rt-net/sciurus17_Hardware/README.md

# Sciurus17_Hardware

[Sciurus17](https://rt-net.jp/products/sciurus17/)のハードウェア資料集です



## フォルダ構成

- `3d_cad_data` : Sciurus17のCADデータ(step)が入っています。
- `3d_print_parts` : Afinia H800+を使った3Dプリント用印刷データと印刷設定リストが入っています。
- `Drawing` : アルミフレームのPDF図面とDXF図面が入っています。

## その他リンク集

- Sciurus17 Getting Start Guide (入門ガイド)
    - [製品ページ](https://rt-net.jp/products/sciurus17/)を参照してください
- [Sciurus17 リンク情報リファレンス](https://docs.google.com/spreadsheets/d/1Q4z3M3cS1pQOEn3iXKLiIQIOr6czvECxSXEPS2-PGvA/edit#gid=870791940)
- [Afinia印刷設定リスト](https://docs.google.com/spreadsheets/d/13tAhwWhuUY1OYwRSI2I5aivEmJeS_VqNS-mdT532pNQ/edit?usp=sharing)
- [組立マニュアル](https://sites.google.com/view/sciurus17-assembly-manual/)
- [部品表](https://docs.google.com/spreadsheets/d/1hBzEDzpoBd0SM8JSYE11qiUdSFQ6FFE922mXjGlsemY/edit?usp=sharing)
- [組立工具リスト](https://docs.google.com/spreadsheets/d/1ffTFrHghpTMQXYzQib9MbFNCAKSNk71CsP23wXIxDos/edit#gid=0)

## 知的財産権について

Sciurus17は、アールティが開発した研究用上半身ロボットです。このリポジトリの情報のライセンスについては、LICENSEファイルをご参照ください。企業による使用については、自社内において研究開発をする目的に限り、本ハードウェア情報の使用を許諾します。本ハードウェア情報を使って自作されたい方は、義務ではありませんが弊社ロボットショップで部品をお買い求めいただければ、励みになります。商業目的をもって本ハードウェア情報を使用する場合は、商業用使用許諾の条件について弊社までお問合せください。

サーボモータのXM540やXM430に関するCADモデルの使用については、ROBOTIS社より使用許諾を受けています。 Sciurus 17に使用されているROBOTIS社の部品類にかかる著作権、商標権、その他の知的財産権は、ROBOTIS社に帰属します。

Proprietary Rights

Sciurus17 is an upper body robot developed by RT Corporation for research purposes. Please read the license information contained in this repository to find out more about licensing. Companies are permitted to use Sciurus17 and the materials made available here for internal, research and development purposes only. If you are interested in building your own robot for your personal use by utilizing the information made available here, take your time to visit our website and purchase relevant components and parts – that will certainly help us keep going! Otherwise, if you are interested in using the hardware information herein on a commercial basis, please contact us to arrange a license and collaboration agreement with us.

We have obtained permission from ROBOTIS Co., Ltd. to use CAD models relating to servo motors XM540 and XM430. The proprietary rights relating to any components or parts manufactured by ROBOTIS and used in this product, including but not limited to copyrights, trademarks, and other intellectual property rights, shall remain vested in ROBOTIS.
