rt-net/sciurus17_Hardware/3d_print_parts/Sciurus17_Left_HandD2.stl

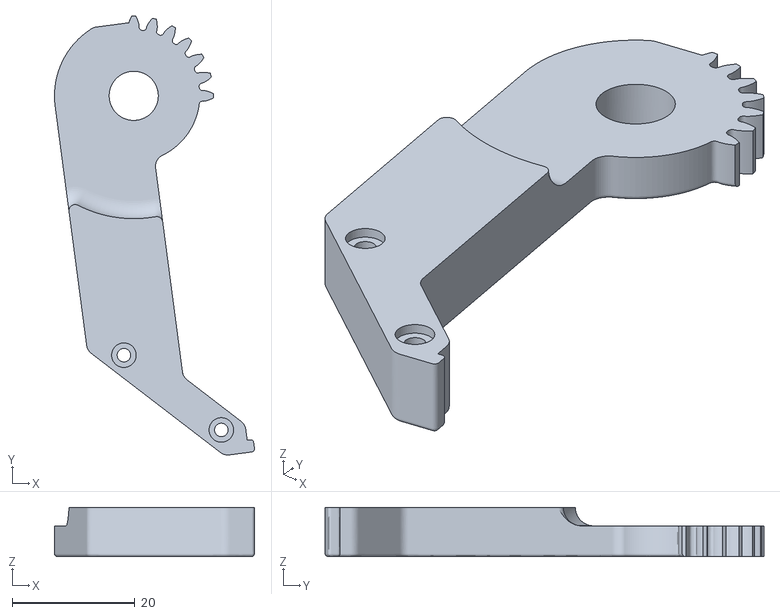
[picture p1: CAD file, 2020-09-11]
3d_print_parts/Sciurus17_Left_HandD2.stl
32.6 x 71.5 x 8.00
