rt-net/sciurus17_Hardware/Drawing/アルミフレームF.dxf

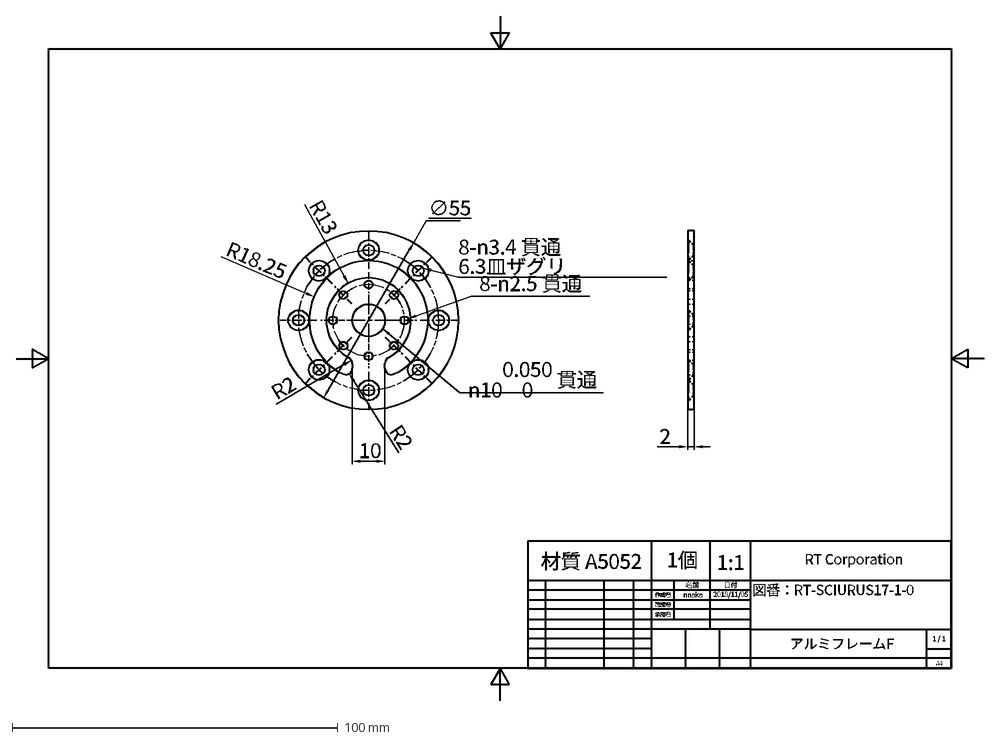
[picture p2: CAD file, 2018-11-06]
Drawing/アルミフレームF.dxf
アルミフレームF
図番：RT-SCIURUS17-1-0
RT Corporation
2018/11/05
nnaka
A4
名前
日付
作成者
確認者
承認者
1 / 1
2
∅55
R13
R18.25
R2
10
1個
材質 A5052
1:1
