rt-net/sciurus17_Hardware/3d_print_parts/Sciurus17_Left_HandD1.stl

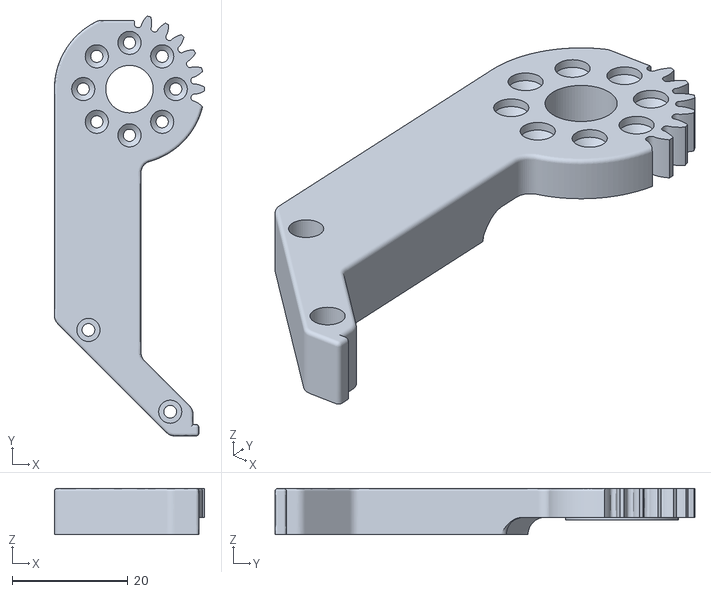
[picture p3: CAD file, 2020-09-11]
3d_print_parts/Sciurus17_Left_HandD1.stl
26.0 x 72.6 x 8.00
