rt-net/sciurus17_Hardware/Drawing/アルミフレームE.dxf

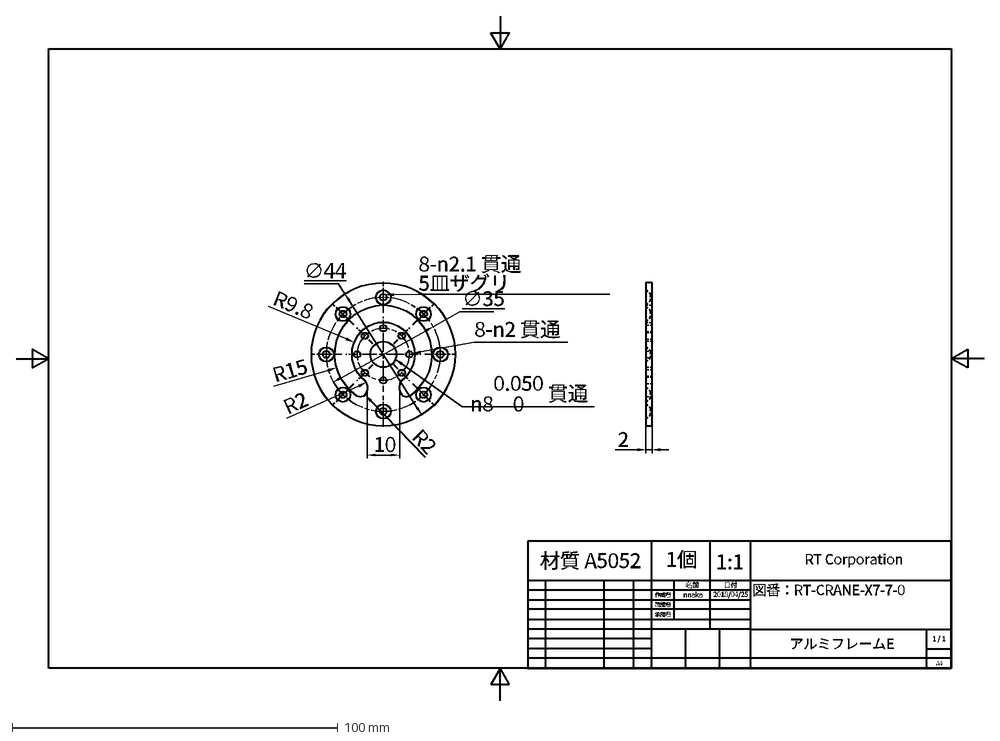
[picture p4: CAD file, 2018-11-06]
Drawing/アルミフレームE.dxf
アルミフレームE
図番：RT-CRANE-X7-7-0
RT Corporation
2018/04/25
nnaka
A4
名前
日付
作成者
確認者
承認者
1 / 1
∅44
∅35
R9.8
R15
10
R2
2
1個
材質 A5052
1:1
