rt-net/sciurus17_Hardware/3d_print_parts/Sciurus17_Right_HandA.stl

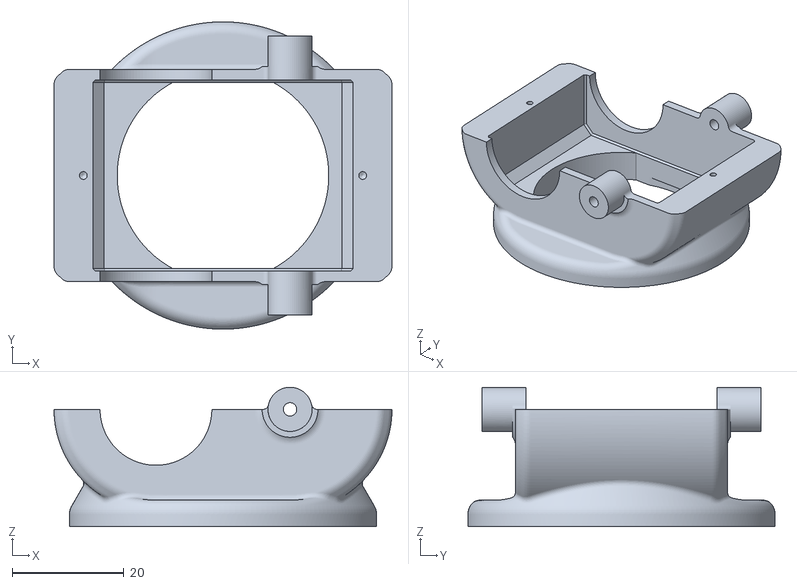
[picture p5: CAD file, 2020-09-11]
3d_print_parts/Sciurus17_Right_HandA.stl
60.5 x 55.0 x 25.0
