rt-net/sciurus17_Hardware/Drawing/アルミフレームD.dxf

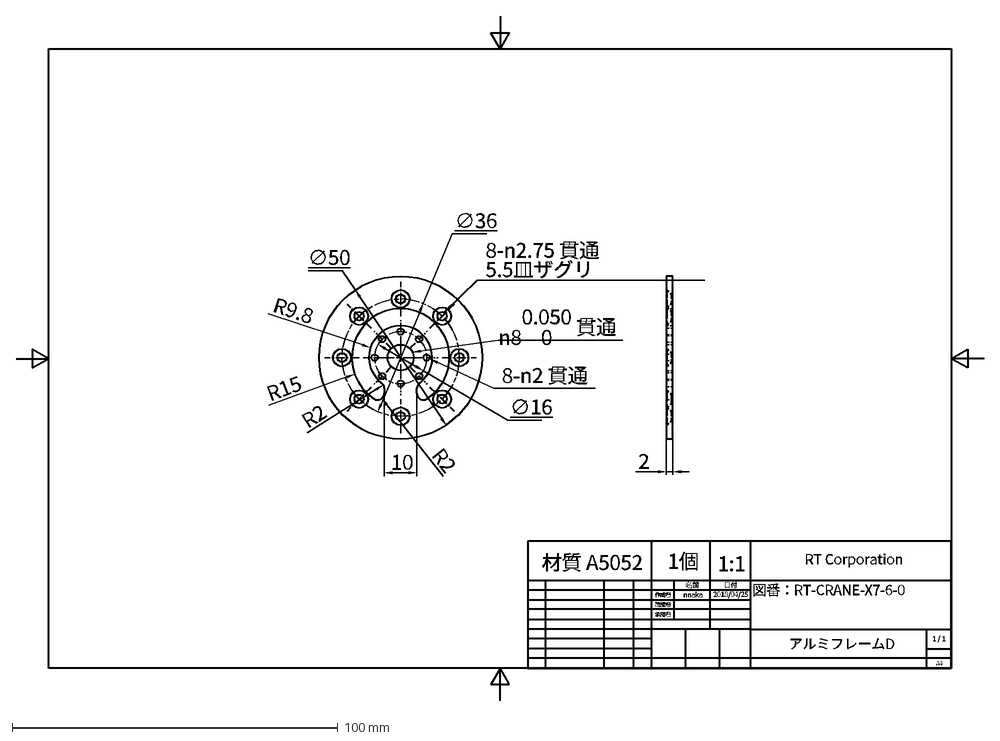
[picture p6: CAD file, 2018-11-06]
Drawing/アルミフレームD.dxf
アルミフレームD
図番：RT-CRANE-X7-6-0
RT Corporation
2018/04/25
nnaka
A4
名前
日付
作成者
確認者
承認者
1 / 1
∅50
∅36
2
10
R2
R9.8
R15
∅16
1:1
材質 A5052
1個
