rt-net/sciurus17_Hardware/3d_print_parts/Sciurus17_Left_HandD4.stl

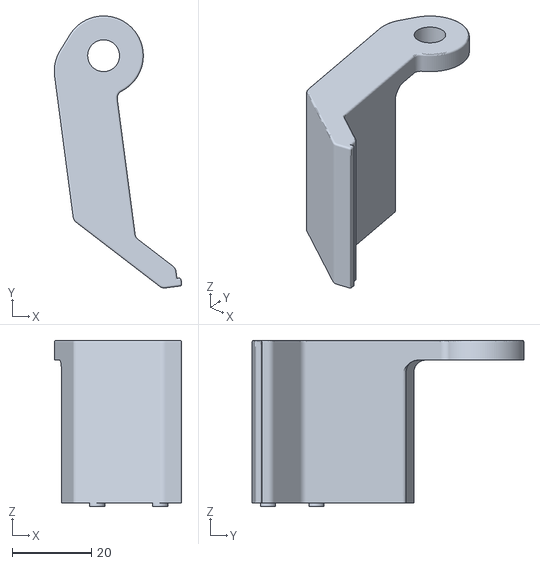
[picture p7: CAD file, 2020-09-11]
3d_print_parts/Sciurus17_Left_HandD4.stl
32.1 x 68.5 x 41.9
