rt-net/sciurus17_Hardware/Drawing/CRANE-X7_HandFrame20180417.dxf

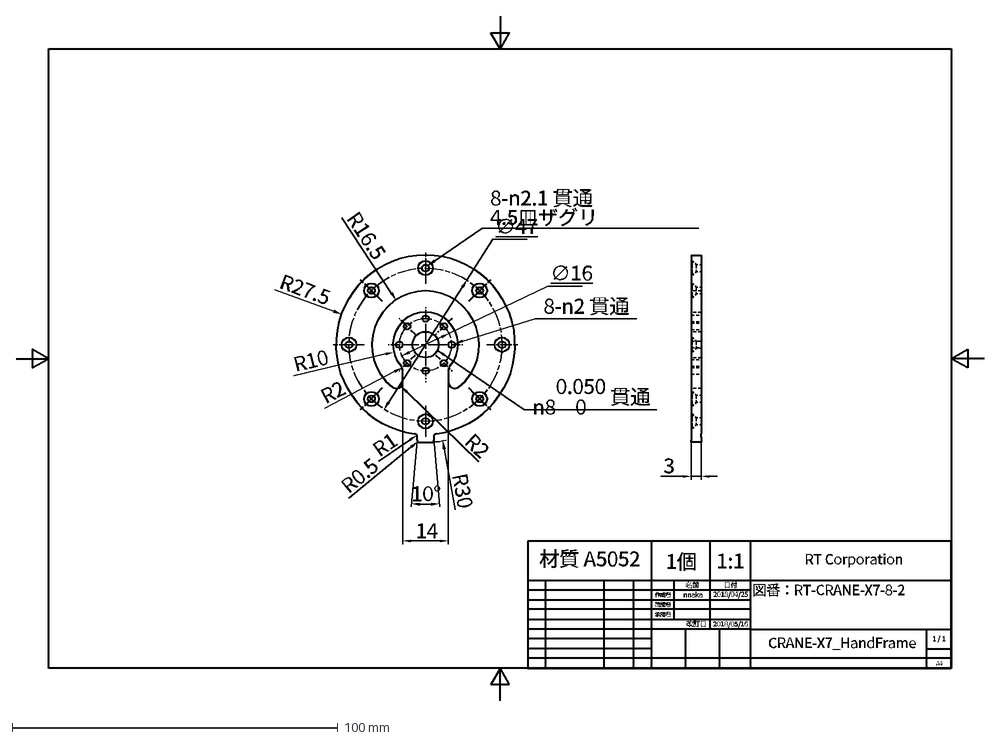
[picture p8: CAD file, 2018-11-06]
Drawing/CRANE-X7_HandFrame20180417.dxf
CRANE-X7_HandFrame
図番：RT-CRANE-X7-8-2
RT Corporation
2018/04/25
nnaka
A4
名前
日付
作成者
確認者
承認者
1 / 1
材質 A5052
1個
1:1
3
R27.5
R16.5
∅47
∅16
10°
R1
R0.5
R30
14
R2
R10
改訂日
2018/05/16
