rt-net/sciurus17_Hardware/3d_print_parts/Sciurus17_Right_HandB.stl

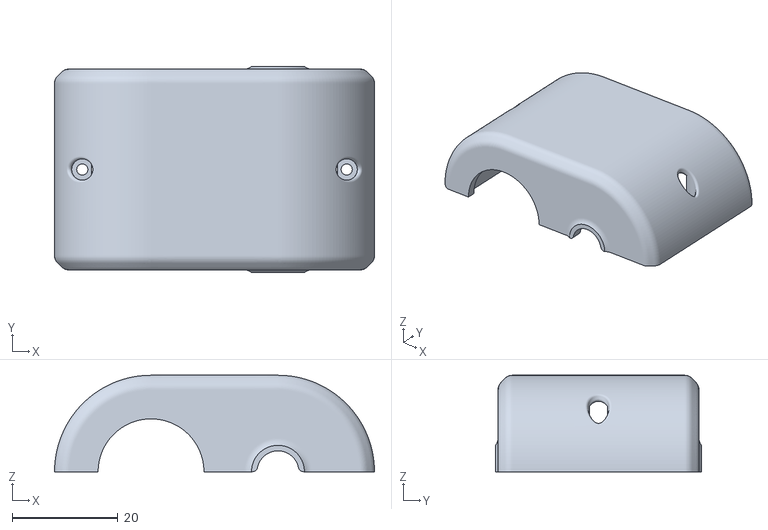
[picture p9: CAD file, 2020-09-11]
3d_print_parts/Sciurus17_Right_HandB.stl
60.5 x 39.0 x 18.3
