rt-net/sciurus17_Hardware/Drawing/アルミフレーム土台A.dxf

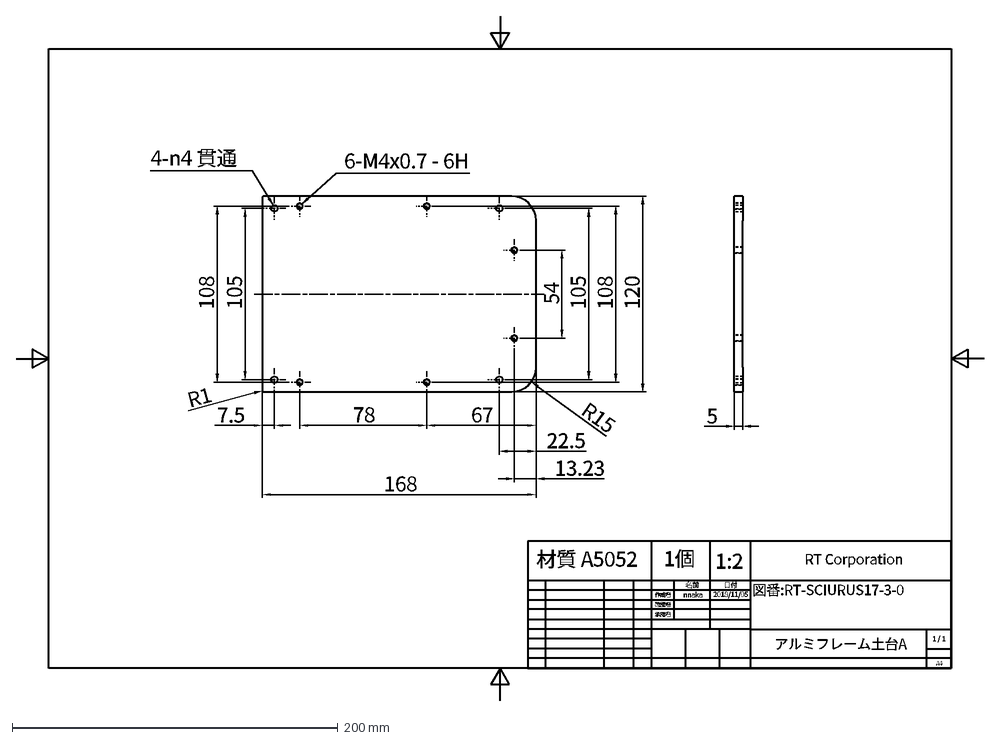
[picture p10: CAD file, 2018-11-06]
Drawing/アルミフレーム土台A.dxf
アルミフレーム土台A
図番:RT-SCIURUS17-3-0
RT Corporation
2018/11/05
nnaka
A4
名前
日付
作成者
確認者
承認者
1 / 1
78
22.5
7.5
67
13.23
54
105
108
120
6-M4x0.7 - 6H
R1
R15
168
5
1個
材質 A5052
1:2
