rt-net/sciurus17_Hardware/3d_print_parts/Sciurus17_Left_HandD3.stl

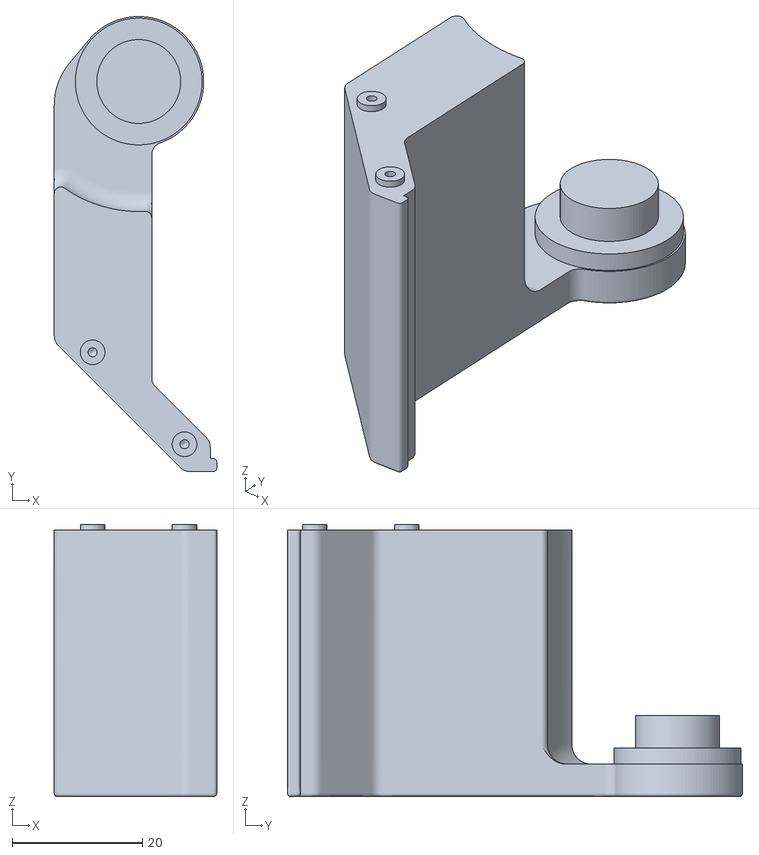
[picture p11: CAD file, 2020-09-11]
3d_print_parts/Sciurus17_Left_HandD3.stl
25.0 x 70.0 x 41.9
