rt-net/sciurus17_Hardware/Drawing/アルミフレームA.dxf

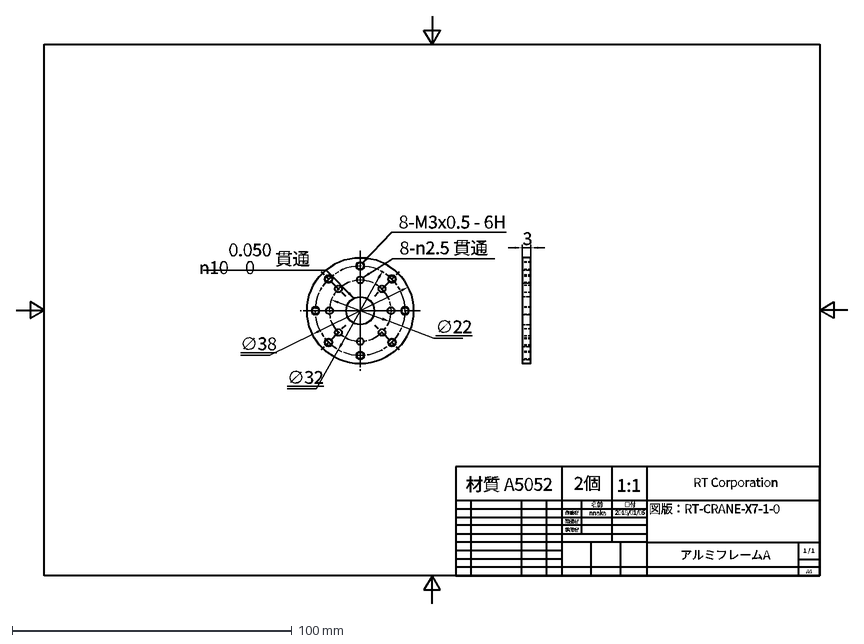
[picture p12: CAD file, 2018-11-06]
Drawing/アルミフレームA.dxf
アルミフレームA
図版：RT-CRANE-X7-1-0
RT Corporation
2018/01/05
nnaka
A4
名前
日付
作成者
確認者
承認者
1 / 1
3
8-M3x0.5 - 6H
∅38
∅32
∅22
1:1
材質 A5052
2個
