rt-net/sciurus17_Hardware/Drawing/アルミフレームB2.dxf

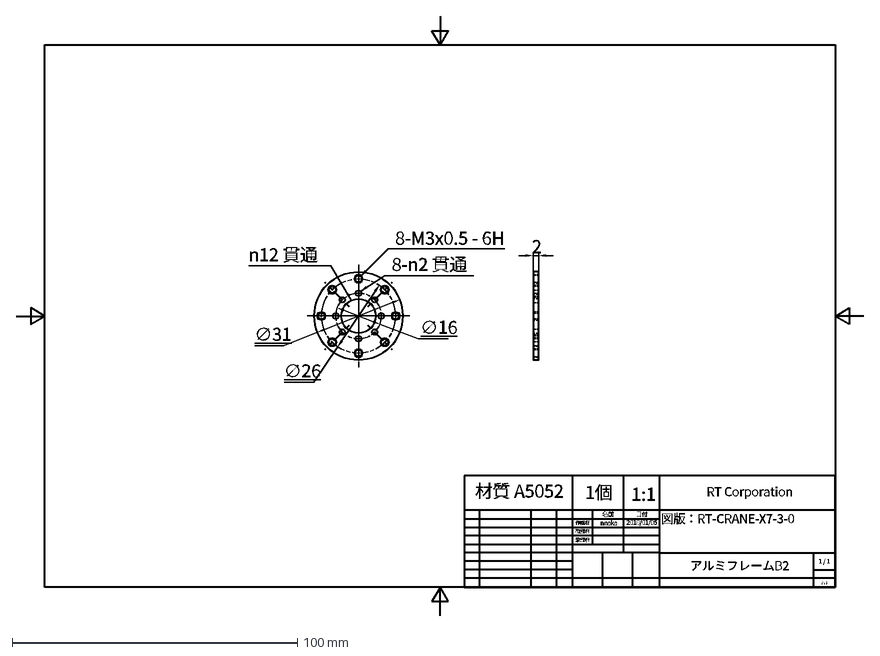
[picture p13: CAD file, 2018-11-06]
Drawing/アルミフレームB2.dxf
アルミフレームB2
図版：RT-CRANE-X7-3-0
RT Corporation
2018/01/05
nnaka
A4
名前
日付
作成者
確認者
承認者
1 / 1
8-M3x0.5 - 6H
∅31
∅26
∅16
2
材質 A5052
1:1
1個
