rt-net/sciurus17_Hardware/3d_print_parts/Sciurus17_Right_HandC.stl

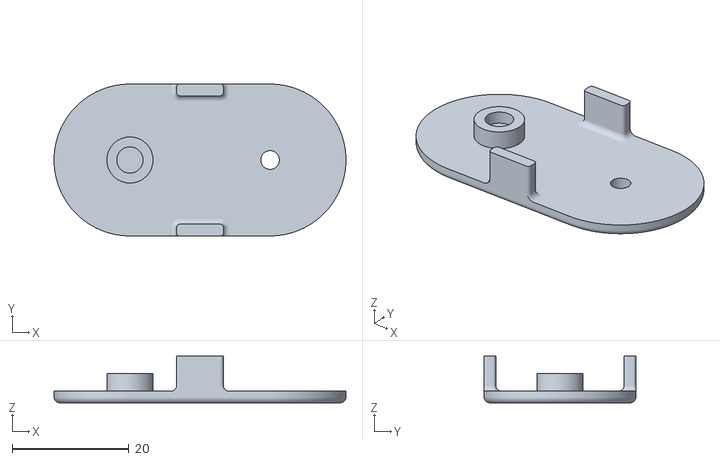
[picture p14: CAD file, 2020-09-11]
3d_print_parts/Sciurus17_Right_HandC.stl
50.0 x 26.0 x 8.00
