rt-net/sciurus17_Hardware/Drawing/アルミフレームB.dxf

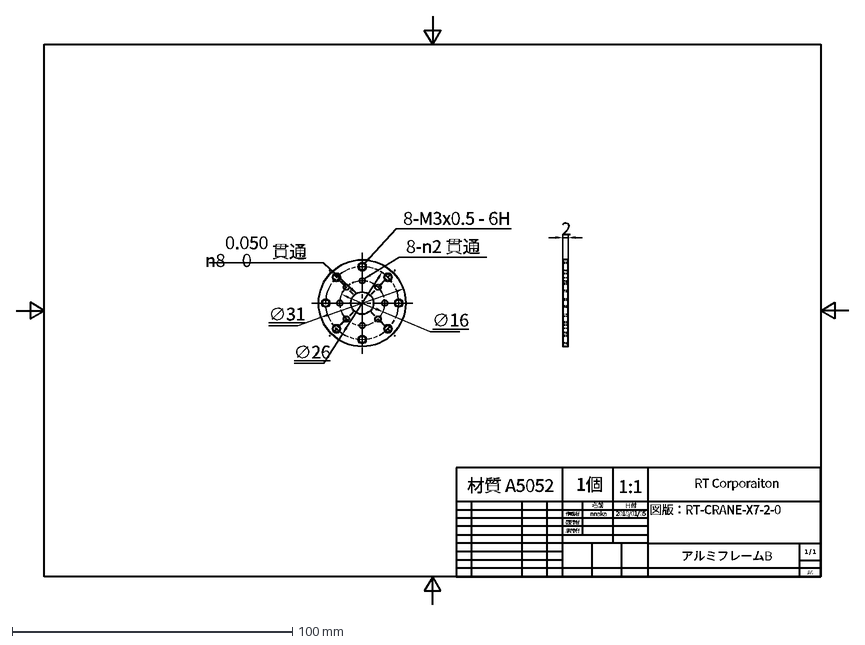
[picture p15: CAD file, 2018-11-06]
Drawing/アルミフレームB.dxf
アルミフレームB
図版：RT-CRANE-X7-2-0
RT Corporaiton
2018/01/05
nnaka
A4
名前
日付
作成者
確認者
承認者
1 / 1
8-M3x0.5 - 6H
∅31
2
1:1
材質 A5052
∅26
∅16
1個
