rt-net/sciurus17_Hardware/Drawing/アルミフレーム(6812ZZ+XM540).dxf

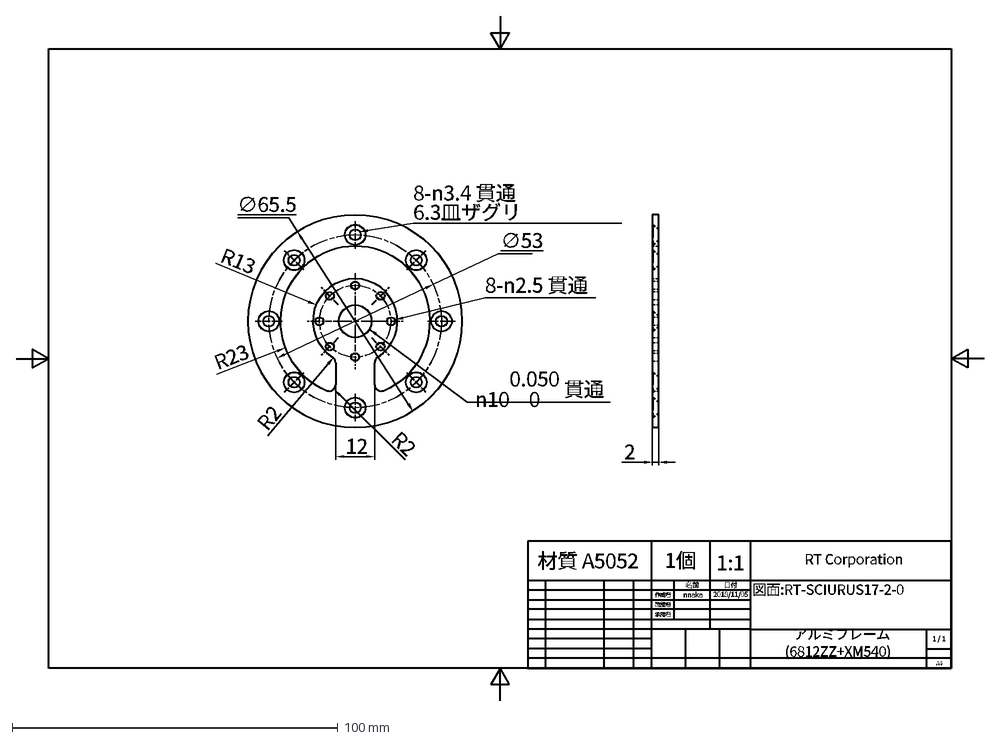
[picture p16: CAD file, 2018-11-06]
Drawing/アルミフレーム(6812ZZ+XM540).dxf
アルミフレーム
図面:RT-SCIURUS17-2-0
RT Corporation
2018/11/05
nnaka
A4
(6812ZZ+XM540)
名前
日付
作成者
確認者
承認者
1 / 1
∅65.5
R13
R23
R2
12
∅53
2
1個
材質 A5052
1:1
