rt-net/sciurus17_Hardware/Drawing/アルミフレーム土台B.dxf

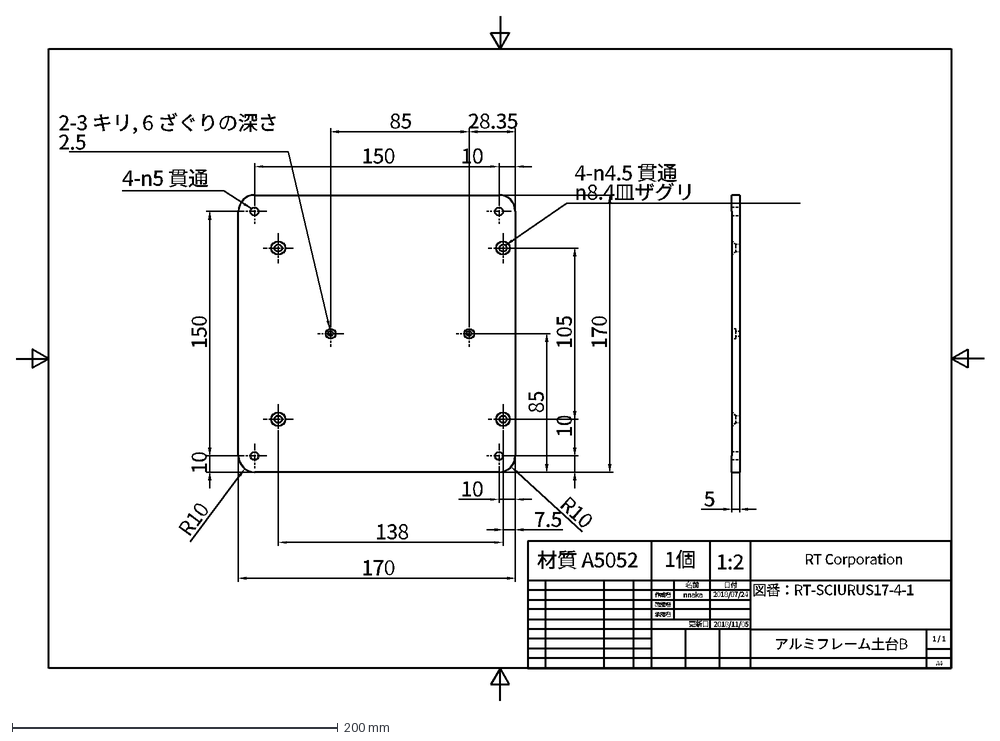
[picture p17: CAD file, 2018-11-06]
Drawing/アルミフレーム土台B.dxf
アルミフレーム土台B
図番：RT-SCIURUS17-4-1
RT Corporation
2018/07/24
nnaka
A4
名前
日付
作成者
確認者
承認者
1 / 1
150
105
85
7.5
138
170
10
2-3 キリ, 6 ざぐりの深さ 2.5
5
28.35
1:2
1個
材質 A5052
R10
更新日
2018/11/05
