rt-net/sciurus17_Hardware/3d_print_parts/Sciurus17_Right_HandD2.stl

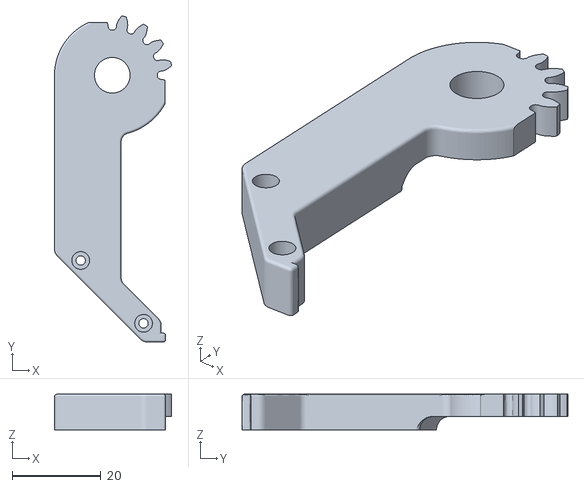
[picture p18: CAD file, 2020-09-11]
3d_print_parts/Sciurus17_Right_HandD2.stl
26.3 x 73.3 x 8.00
