rt-net/sciurus17_Hardware/3d_print_parts/Sciurus17_Right_Link4B.stl

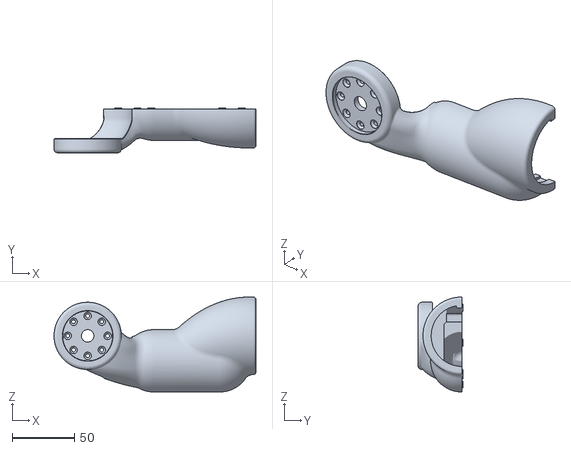
[picture p19: CAD file, 2018-10-31]
3d_print_parts/Sciurus17_Right_Link4B.stl
162.0 x 35.9 x 76.2
