rt-net/sciurus17_Hardware/3d_print_parts/Sciurus17_Left_Link2D.stl

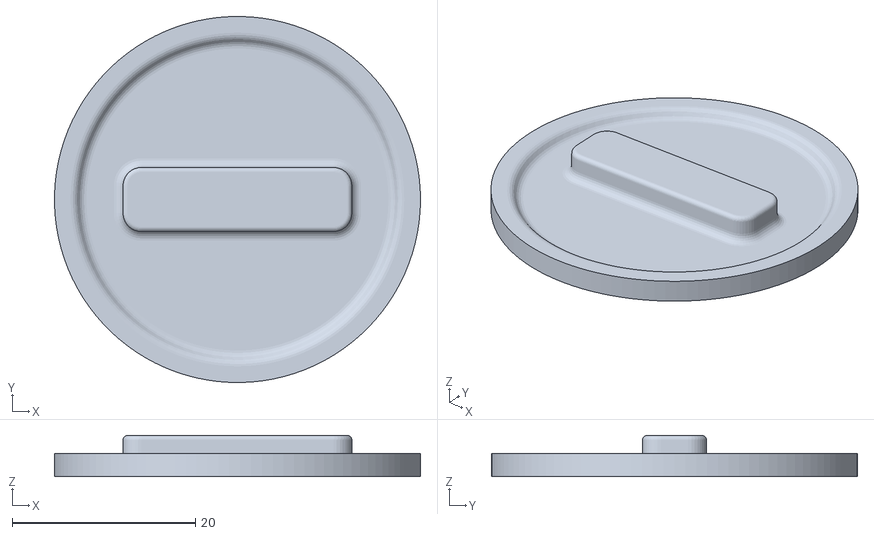
[picture p20: CAD file, 2018-10-31]
3d_print_parts/Sciurus17_Left_Link2D.stl
40.0 x 40.0 x 4.50
