rt-net/sciurus17_Hardware/3d_print_parts/Sciurus17_Right_Link3B.stl

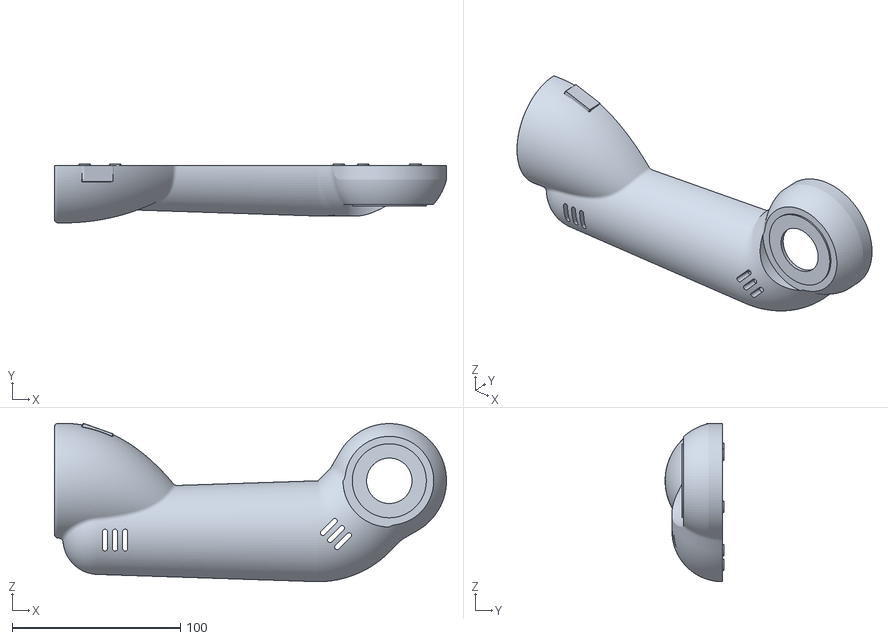
[picture p21: CAD file, 2018-10-31]
3d_print_parts/Sciurus17_Right_Link3B.stl
233.0 x 35.0 x 94.2
