rt-net/sciurus17_Hardware/3d_print_parts/Sciurus17_Left_Link6B.stl

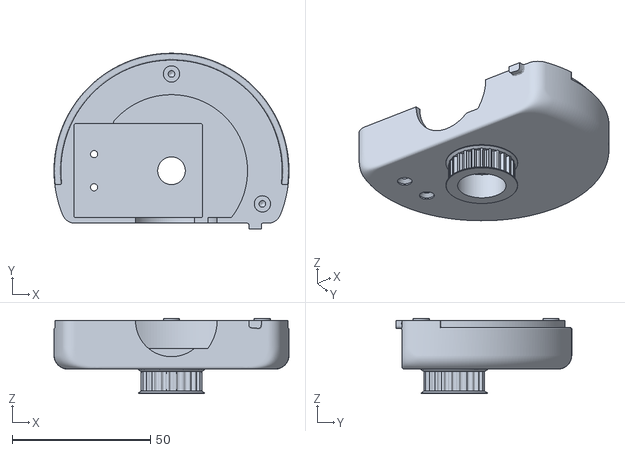
[picture p22: CAD file, 2018-10-31]
3d_print_parts/Sciurus17_Left_Link6B.stl
85.0 x 63.5 x 27.3
