rt-net/sciurus17_Hardware/3d_print_parts/Sciurus17_Left_Link2C.stl

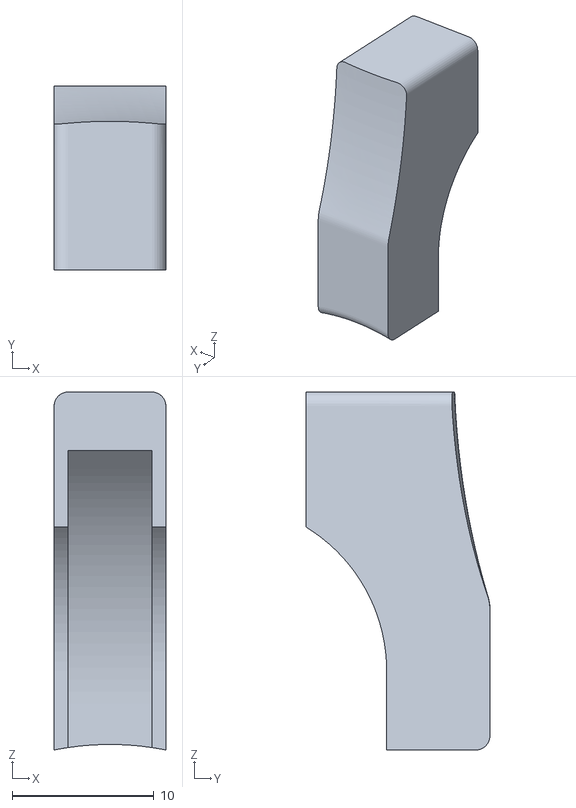
[picture p23: CAD file, 2018-10-31]
3d_print_parts/Sciurus17_Left_Link2C.stl
7.90 x 13.0 x 25.3
