rt-net/sciurus17_Hardware/3d_print_parts/Sciurus17_Right_Link6A.stl

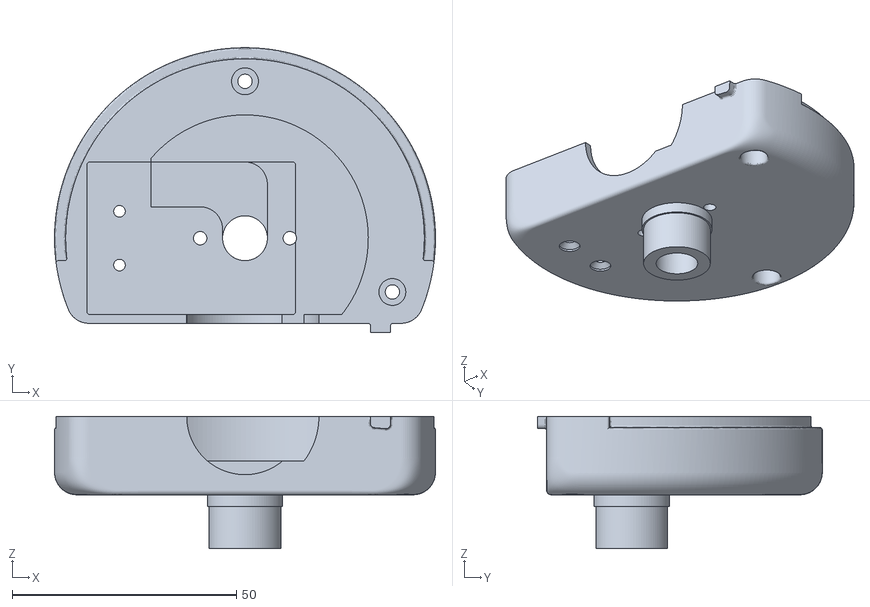
[picture p24: CAD file, 2018-10-31]
3d_print_parts/Sciurus17_Right_Link6A.stl
85.0 x 63.5 x 29.5
