rt-net/sciurus17_Hardware/3d_print_parts/Sciurus17_Left_Link1B.stl

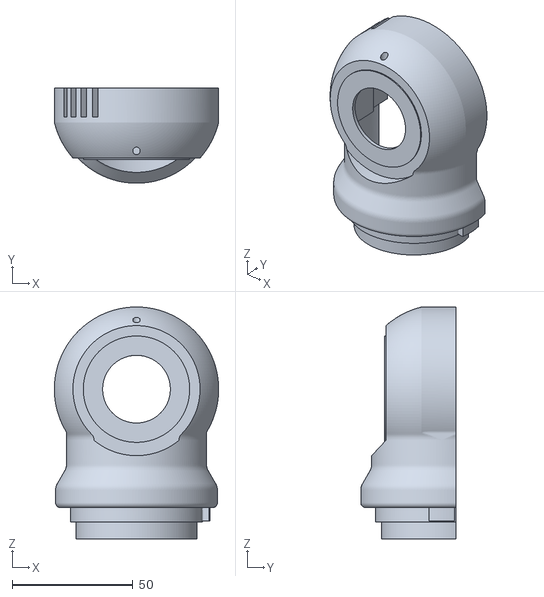
[picture p25: CAD file, 2018-10-31]
3d_print_parts/Sciurus17_Left_Link1B.stl
68.0 x 39.5 x 96.0
