rt-net/sciurus17_Hardware/3d_print_parts/Sciurus17_Left_Link5B.stl

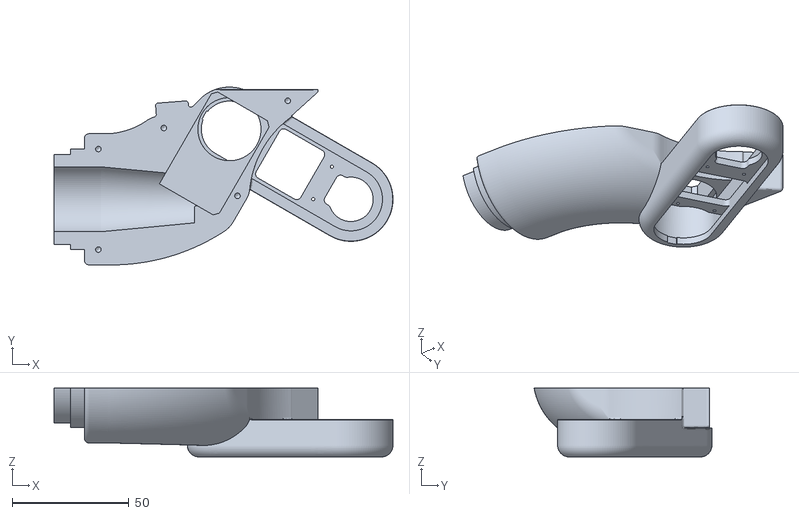
[picture p26: CAD file, 2018-10-31]
3d_print_parts/Sciurus17_Left_Link5B.stl
145.0 x 76.1 x 29.5
