rt-net/sciurus17_Hardware/3d_print_parts/Sciurus17_Right_BaseB.stl

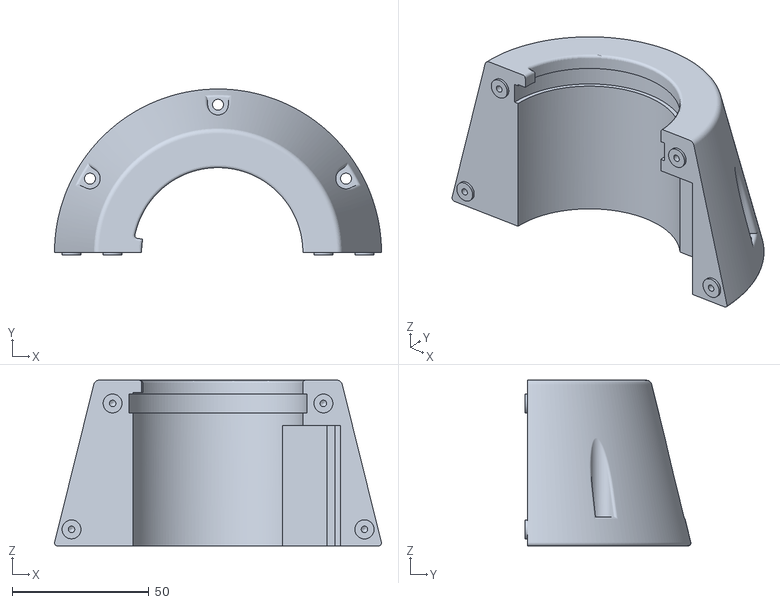
[picture p27: CAD file, 2018-10-31]
3d_print_parts/Sciurus17_Right_BaseB.stl
119.4 x 60.6 x 60.5
