rt-net/sciurus17_Hardware/3d_print_parts/Sciurus17_Left_Link5C.stl

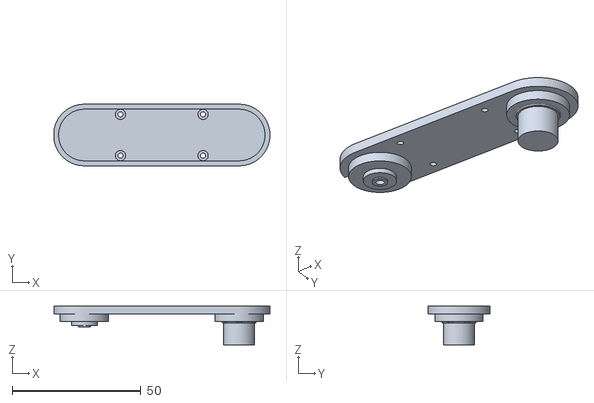
[picture p28: CAD file, 2018-10-31]
3d_print_parts/Sciurus17_Left_Link5C.stl
83.7 x 23.9 x 15.0
