rt-net/sciurus17_Hardware/3d_print_parts/Sciurus17_Right_Link2B.stl

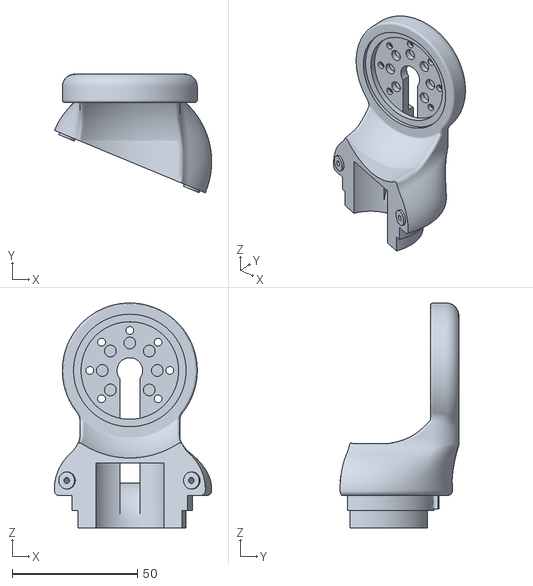
[picture p29: CAD file, 2018-10-31]
3d_print_parts/Sciurus17_Right_Link2B.stl
62.9 x 47.5 x 90.0
