rt-net/sciurus17_Hardware/3d_print_parts/Sciurus17_Right_Link5D.stl

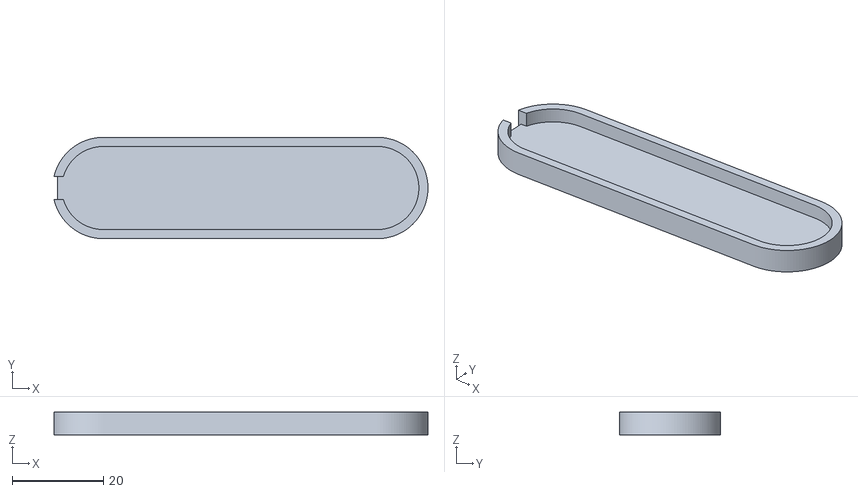
[picture p30: CAD file, 2018-10-31]
3d_print_parts/Sciurus17_Right_Link5D.stl
81.9 x 22.2 x 5.00
