rt-net/sciurus17_Hardware/3d_print_parts/Sciurus17_Right_Link5A.stl

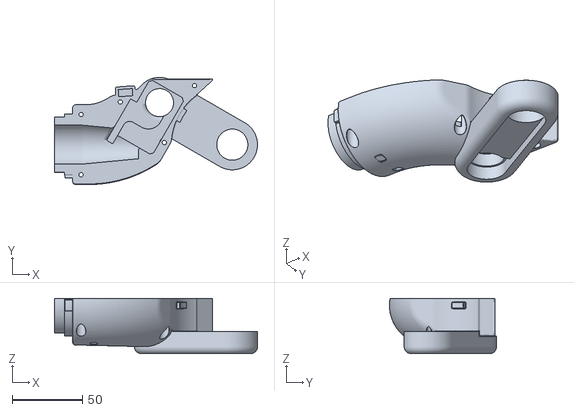
[picture p31: CAD file, 2018-10-31]
3d_print_parts/Sciurus17_Right_Link5A.stl
145.0 x 76.5 x 39.5
