rt-net/sciurus17_Hardware/3d_print_parts/Sciurus17_Right_BaseA.stl

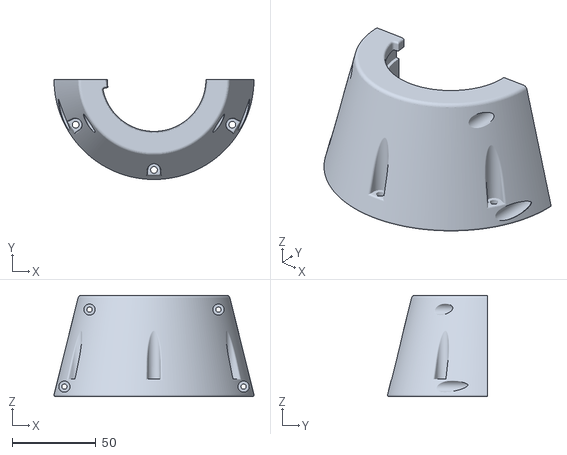
[picture p32: CAD file, 2018-10-31]
3d_print_parts/Sciurus17_Right_BaseA.stl
119.4 x 59.7 x 60.5
