rt-net/sciurus17_Hardware/3d_print_parts/Sciurus17_Right_Link4C.stl

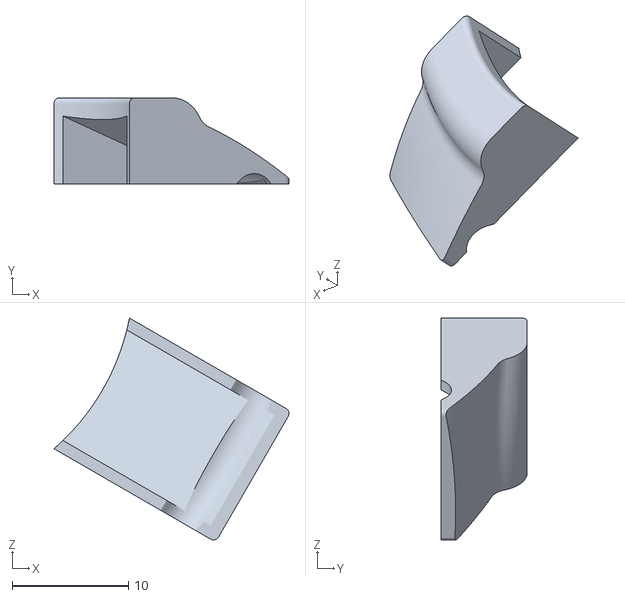
[picture p33: CAD file, 2018-10-31]
3d_print_parts/Sciurus17_Right_Link4C.stl
20.2 x 7.45 x 19.1
