rt-net/sciurus17_Hardware/3d_print_parts/Sciurus17_Left_Link5E.stl

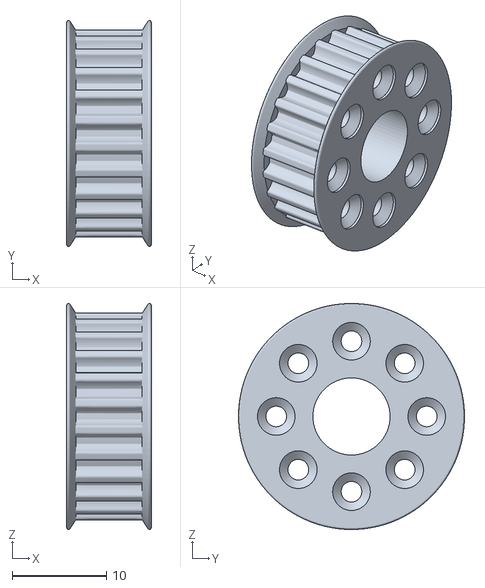
[picture p34: CAD file, 2018-10-31]
3d_print_parts/Sciurus17_Left_Link5E.stl
9.00 x 24.0 x 24.0
