rt-net/sciurus17_Hardware/3d_print_parts/Sciurus17_Left_Link4A.stl

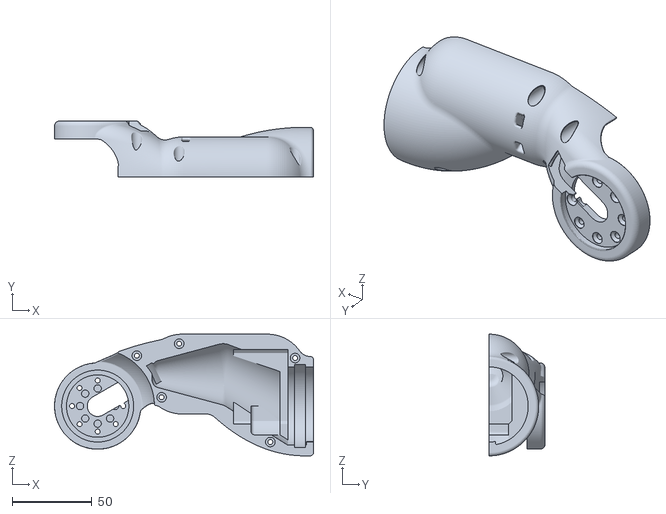
[picture p35: CAD file, 2018-10-31]
3d_print_parts/Sciurus17_Left_Link4A.stl
162.0 x 35.0 x 76.2
