rt-net/sciurus17_Hardware/3d_print_parts/Sciurus17_Left_Link2A.stl

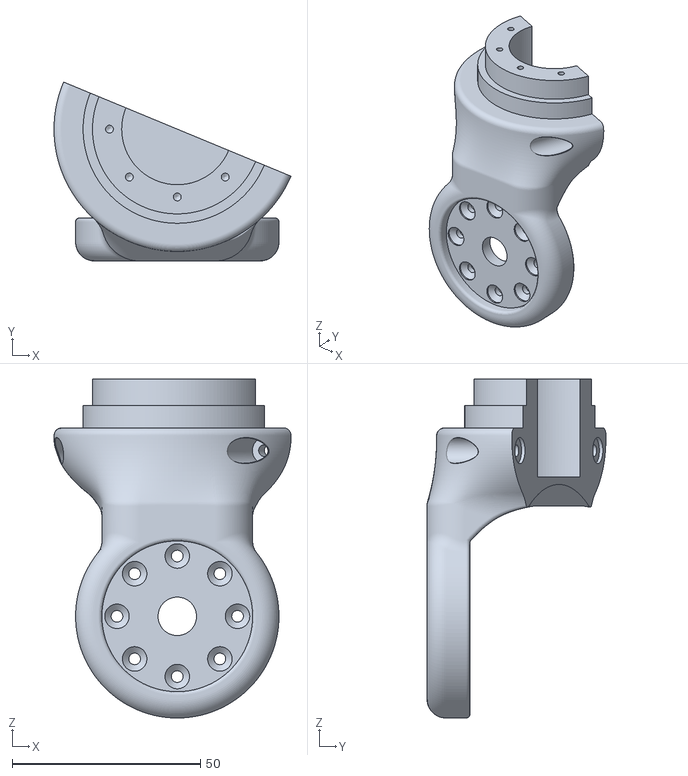
[picture p36: CAD file, 2018-10-31]
3d_print_parts/Sciurus17_Left_Link2A.stl
62.9 x 47.5 x 90.0
