rt-net/sciurus17_Hardware/3d_print_parts/Sciurus17_Right_Link1A.stl

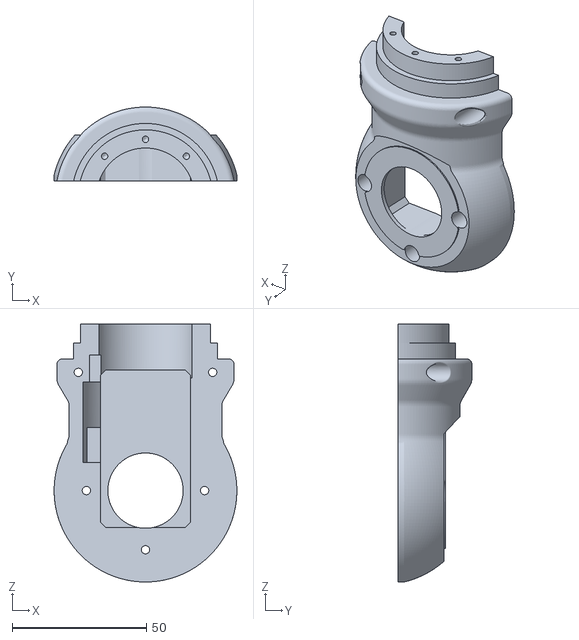
[picture p37: CAD file, 2018-10-31]
3d_print_parts/Sciurus17_Right_Link1A.stl
68.0 x 27.5 x 96.0
