rt-net/sciurus17_Hardware/3d_print_parts/Sciurus17_Left_Link3A.stl

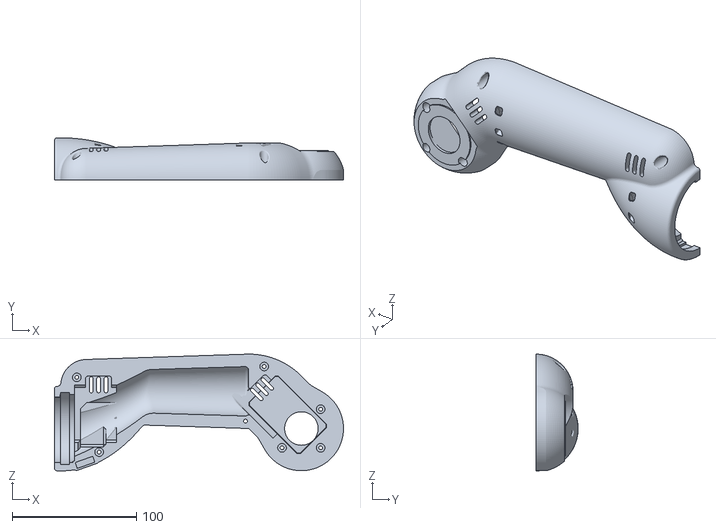
[picture p38: CAD file, 2018-10-31]
3d_print_parts/Sciurus17_Left_Link3A.stl
233.0 x 34.1 x 94.2
