rt-net/sciurus17_Hardware/3d_print_parts/Sciurus17_BodyA2.stl

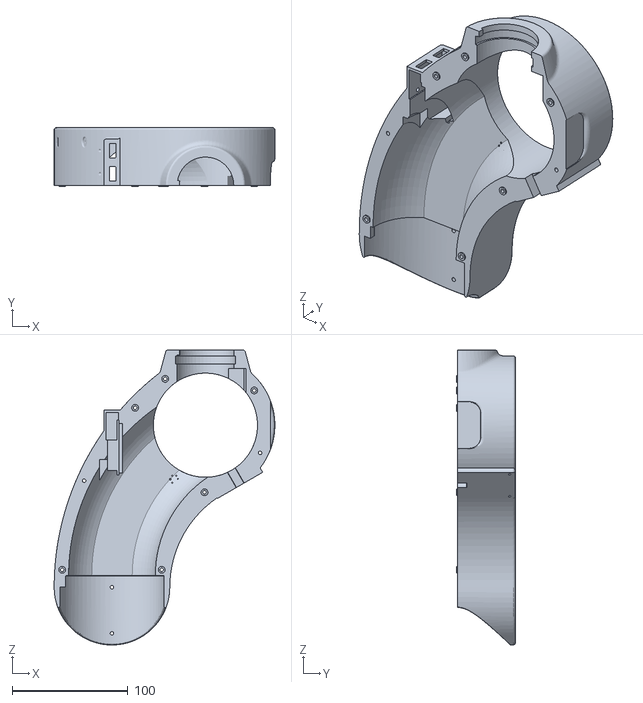
[picture p39: CAD file, 2018-10-31]
3d_print_parts/Sciurus17_BodyA2.stl
190.8 x 50.9 x 255.0
