rt-net/sciurus17_Hardware/3d_print_parts/Sciurus17_HipB1.stl

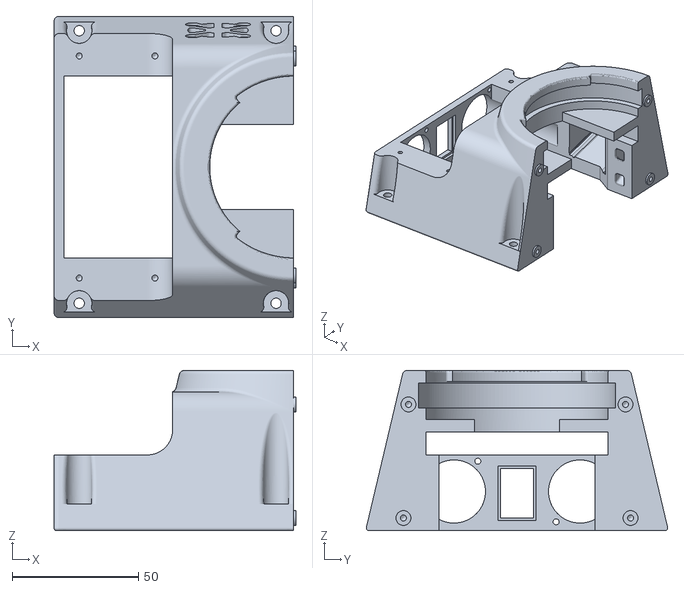
[picture p40: CAD file, 2018-10-31]
3d_print_parts/Sciurus17_HipB1.stl
95.9 x 119.5 x 63.5
