rt-net/sciurus17_Hardware/3d_print_parts/Sciurus17_BodyC.stl

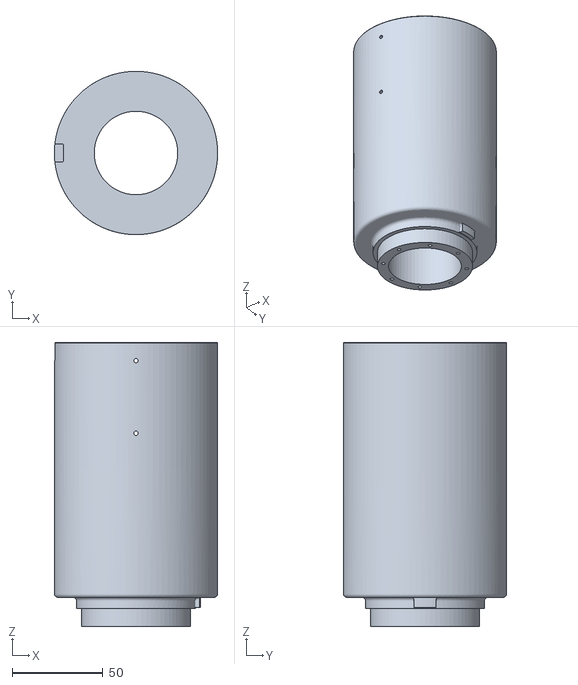
[picture p42: CAD file, 2018-10-31]
3d_print_parts/Sciurus17_BodyC.stl
90.0 x 90.0 x 156.5
