rt-net/sciurus17_Hardware/3d_print_parts/Sciurus17_BodyA1.stl

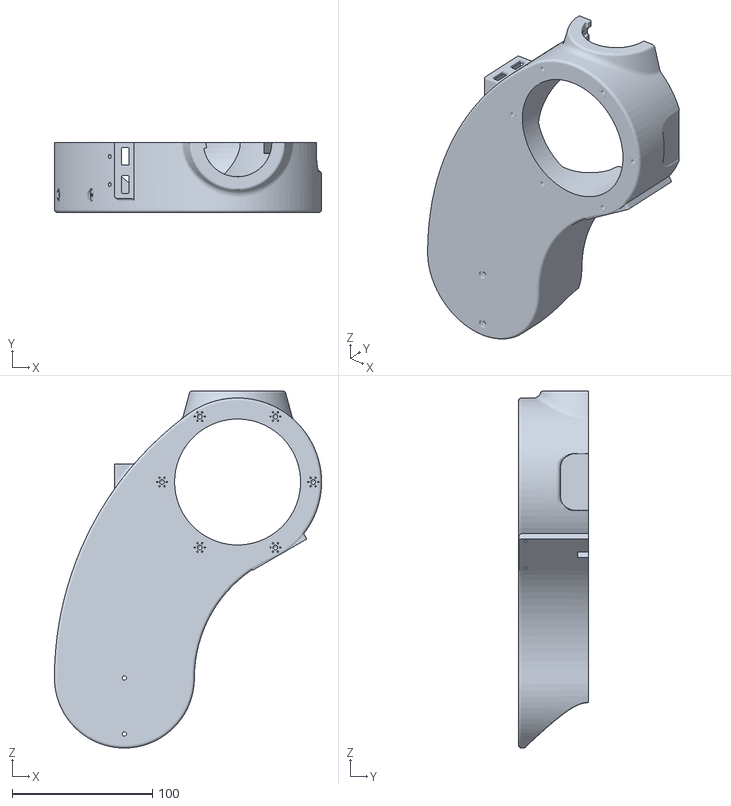
[picture p43: CAD file, 2018-10-31]
3d_print_parts/Sciurus17_BodyA1.stl
190.8 x 50.0 x 255.0
