rt-net/sciurus17_Hardware/3d_print_parts/Sciurus17_HipA.stl

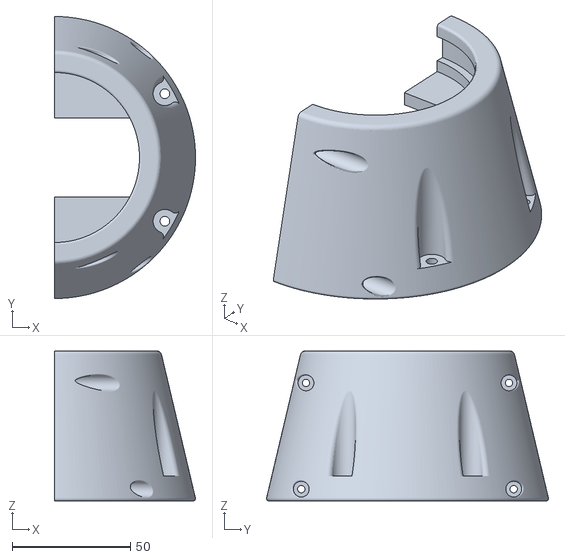
[picture p44: CAD file, 2018-10-31]
3d_print_parts/Sciurus17_HipA.stl
59.7 x 119.5 x 63.5
