rt-net/sciurus17_Hardware/3d_print_parts/Sciurus17_BaseCover.stl

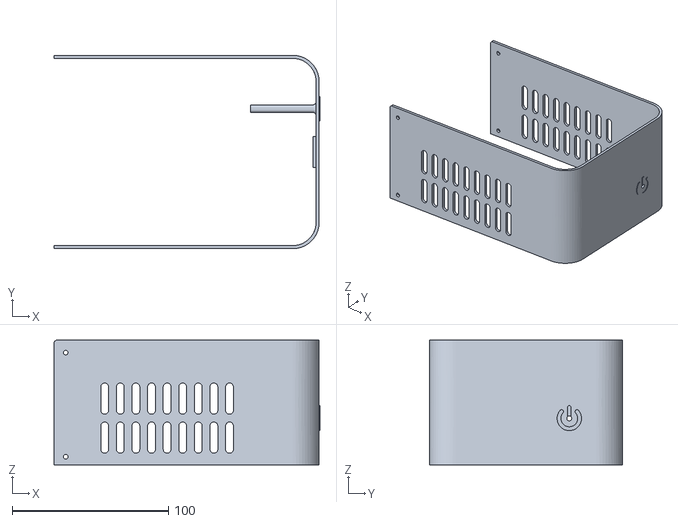
[picture p45: CAD file, 2018-10-31]
3d_print_parts/Sciurus17_BaseCover.stl
170.5 x 124.0 x 80.0
