rt-net/sciurus17_Hardware/3d_print_parts/Sciurus17_HipB2.stl

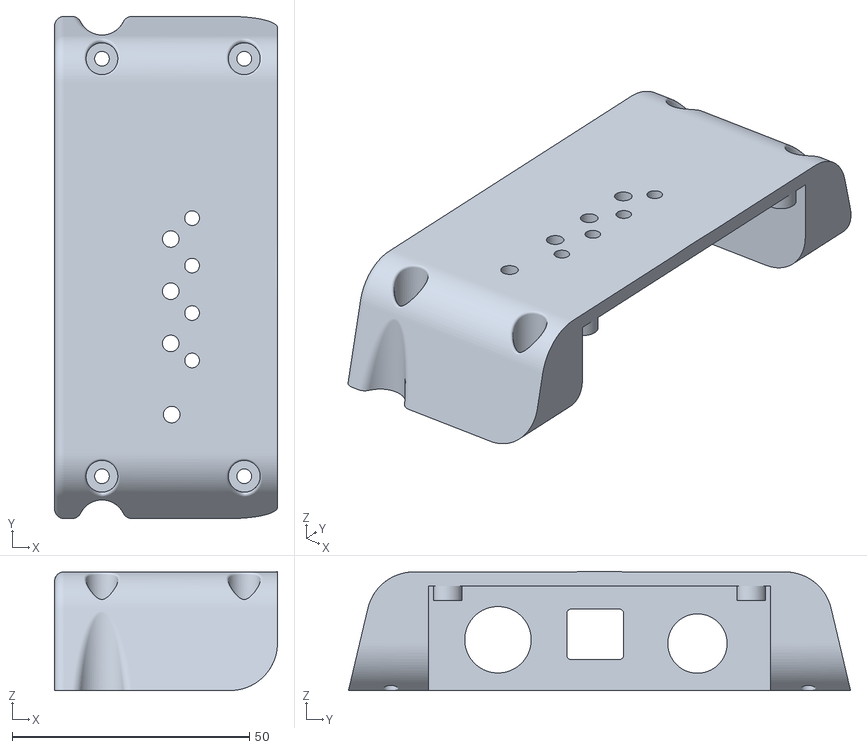
[picture p46: CAD file, 2018-10-31]
3d_print_parts/Sciurus17_HipB2.stl
47.0 x 105.8 x 25.1
