rt-net/sciurus17_Hardware/3d_print_parts/Sciurus17_CameraBustMountB.stl

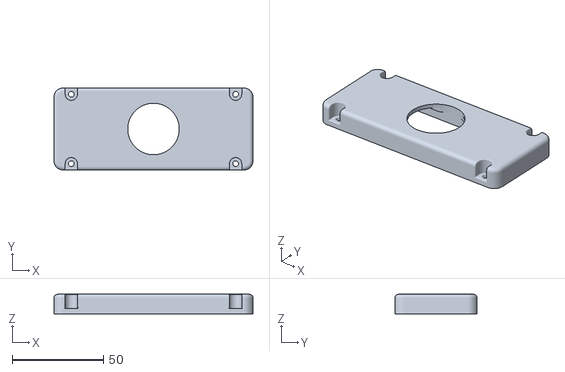
[picture p47: CAD file, 2018-10-31]
3d_print_parts/Sciurus17_CameraBustMountB.stl
109.0 x 45.0 x 10.7
