rt-net/sciurus17_Hardware/3d_print_parts/Sciurus17_HeadA1.stl

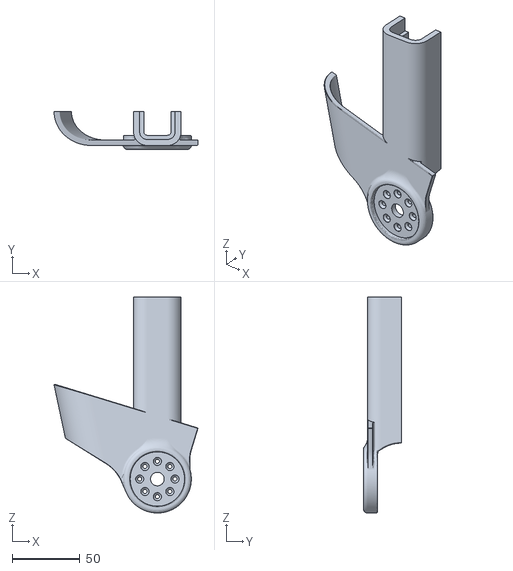
[picture p48: CAD file, 2018-10-31]
3d_print_parts/Sciurus17_HeadA1.stl
105.9 x 28.0 x 159.0
