rt-net/sciurus17_Hardware/3d_print_parts/Sciurus17_NeckB.stl

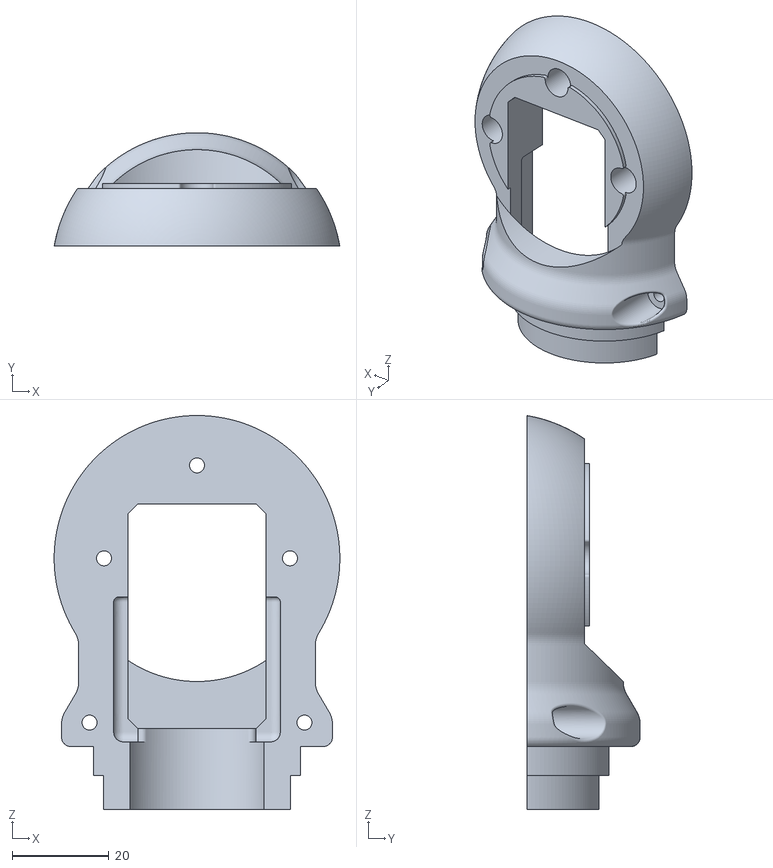
[picture p49: CAD file, 2018-10-31]
3d_print_parts/Sciurus17_NeckB.stl
59.2 x 23.5 x 81.6
