rt-net/sciurus17_Hardware/3d_print_parts/Sciurus17_HeadA3.stl

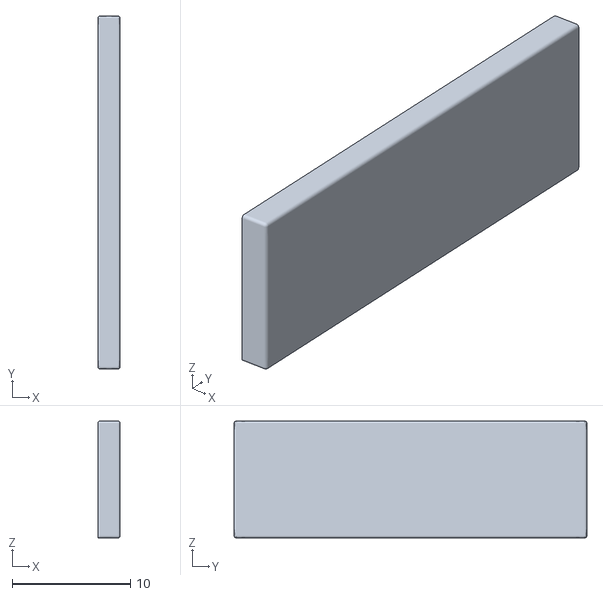
[picture p50: CAD file, 2018-10-31]
3d_print_parts/Sciurus17_HeadA3.stl
1.90 x 29.9 x 9.90
