rt-net/sciurus17_Hardware/3d_print_parts/Sciurus17_NeckA.stl

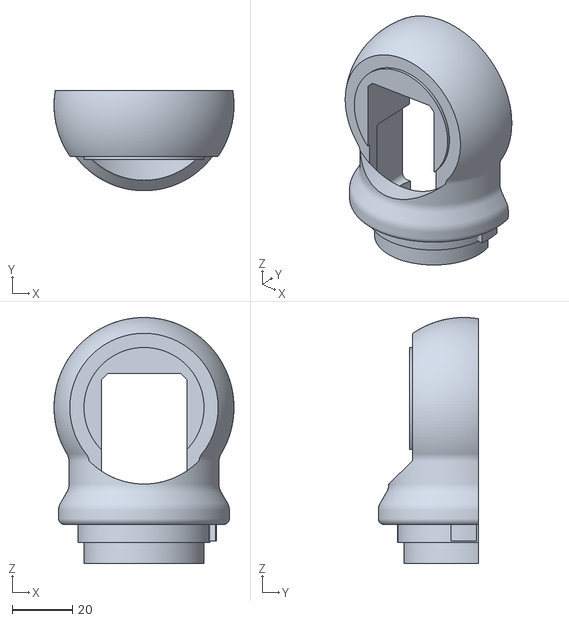
[picture p51: CAD file, 2018-10-31]
3d_print_parts/Sciurus17_NeckA.stl
60.0 x 33.5 x 82.0
