rt-net/sciurus17_Hardware/(list of files, cad)

Other CAD files:
3d_print_parts/Sciurus17_Right_HandD1.stl
3d_print_parts/Sciurus17_Right_HandD4.stl
3d_print_parts/Sciurus17_Right_HandD3.stl
3d_print_parts/Sciurus17_Left_Link2B.stl
3d_print_parts/Sciurus17_Left_Link5A.stl
3d_print_parts/Sciurus17_Left_BaseB.stl
3d_print_parts/Sciurus17_Right_Link5B.stl
3d_print_parts/Sciurus17_Right_Link6B.stl
3d_print_parts/Sciurus17_Left_Link3B.stl
3d_print_parts/Sciurus17_Right_Link1B.stl
3d_print_parts/Sciurus17_Left_Link4B.stl
3d_print_parts/Sciurus17_Left_Link6A.stl
3d_print_parts/Sciurus17_Left_Link4C.stl
3d_print_parts/Sciurus17_Right_Link4A.stl
3d_print_parts/Sciurus17_Left_Link1A.stl
3d_print_parts/Sciurus17_Right_Link3A.stl
3d_print_parts/Sciurus17_Right_Link2A.stl
3d_print_parts/Sciurus17_Left_BaseA.stl
