rt-net/sciurus17_Hardware/(threads)

Thread 2 (2021-08-02):

首が下を向いているとホームモーションが再生できません

ShotaAk, 2021-08-02:
<!-- 品質向上にご協力ありがとうございます -->
<!-- テンプレートを参考に文章を作成してください -->

# 不具合の概要

首が下を向いていると、Sciurus17操作パネルのボタン操作によるホームモーションが再生できません。

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

# 原因

首ピッチ軸（サーボID20）のサーボパラメータに設定されている可動範囲が狭いため、
首を下に向けるだけで可動範囲を超えます。
そのため、ホームモーション再生時に動作エラーが発生し、モーション再生が中断されます。

# 対策

Dynamixel Wizard 2でサーボパラメータを編集し、可動範囲を広げることで解決します。

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

Thread 3 (2023-12-18):

手首ジョイント（l_joint6）の0点再設定方法に関しまして。

ry0hei-kobayashi, 2023-12-18:
お世話になっております。
手首ジョイントの０点がずれてしまったため再設定を行いたいと考えております。
実行環境は、Ubuntu20.04 ,ROS noetic ,sciurus17実機です。sciurus17_moveit_configのdemo.launchとsciurus17_examplesのpick_and_place_two_arm_demo.pyの82行目までを実行しtwo_arm_init_poseの状態にしたときのrvizを添付します。

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

図のように、rviz上のl_joint6の０点がr_joint6に比べてずれています。実機の方はinit_poseのときはrrvizのようなズレはありませんがpick_and_place_two_arm_demoの83行以降を実行してarmが遷移すると、角度にズレが生じてしまいます。
０点の再設定を行う方法はありますでしょうか。宜しくお願いします。

ry0hei-kobayashi, 2023-12-20:
追記
rviz上は依然ずれたままです。実機の方はl_joint6を分解、タイミングベルトとサーボホーン
の角度を調整したところ改善されました。

ShotaAk, 2023-12-27:
@ry0hei-kobayashi
0点のズレは、joint6（手首ピッチ軸）のハードウェア（サーボ原点 or ベルト位置）に問題があると思われます。

RViz上で腕を適当に動かした後、`two_arm_init_pose`へ動かした場合、手首にズレが生じるか確認してもらえますか？

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

- 実機にズレはないが、RViz上のモデルにズレがある場合：
  - two_arm_init_poseの指示値が書き換わっている可能性があります
  - https://github.com/rt-net/sciurus17_ros/blob/02182bb7aee4b79ef87c783d8e44acbc58429f32/sciurus17_moveit_config/config/sciurus17.srdf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
- RViz上のモデルにズレはないが、実機にずれがある場合：
  - ハードウェアのベルト位置、あるいはサーボ原点（Homing Offset）に原因があります

ry0hei-kobayashi, 2024-02-15:
トラブルシューティング方法を教示いただきありがとうございます．
適当に動かした後にtwo_arm_init_poseへ移動させたところ左右の角度ズレが確認できました．（後者の状況）
組み立てマニュアルを参照してl_joint6のベルト位置を調整したところ解決し，実機・Rvizともに角度ズレが限りなく小さくなりました．

YusukeKato, 2025-05-21:
こちらのIssueは解決済みかと思いますのでクローズさせていただきます。
他に何かありましたら再度オープンしてご質問いただけたらと思います。

Closed 2025-05-21.
