rt-net/sciurus17_Hardware/Drawing/CRANE-X7_HandFrame20180417.pdf

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

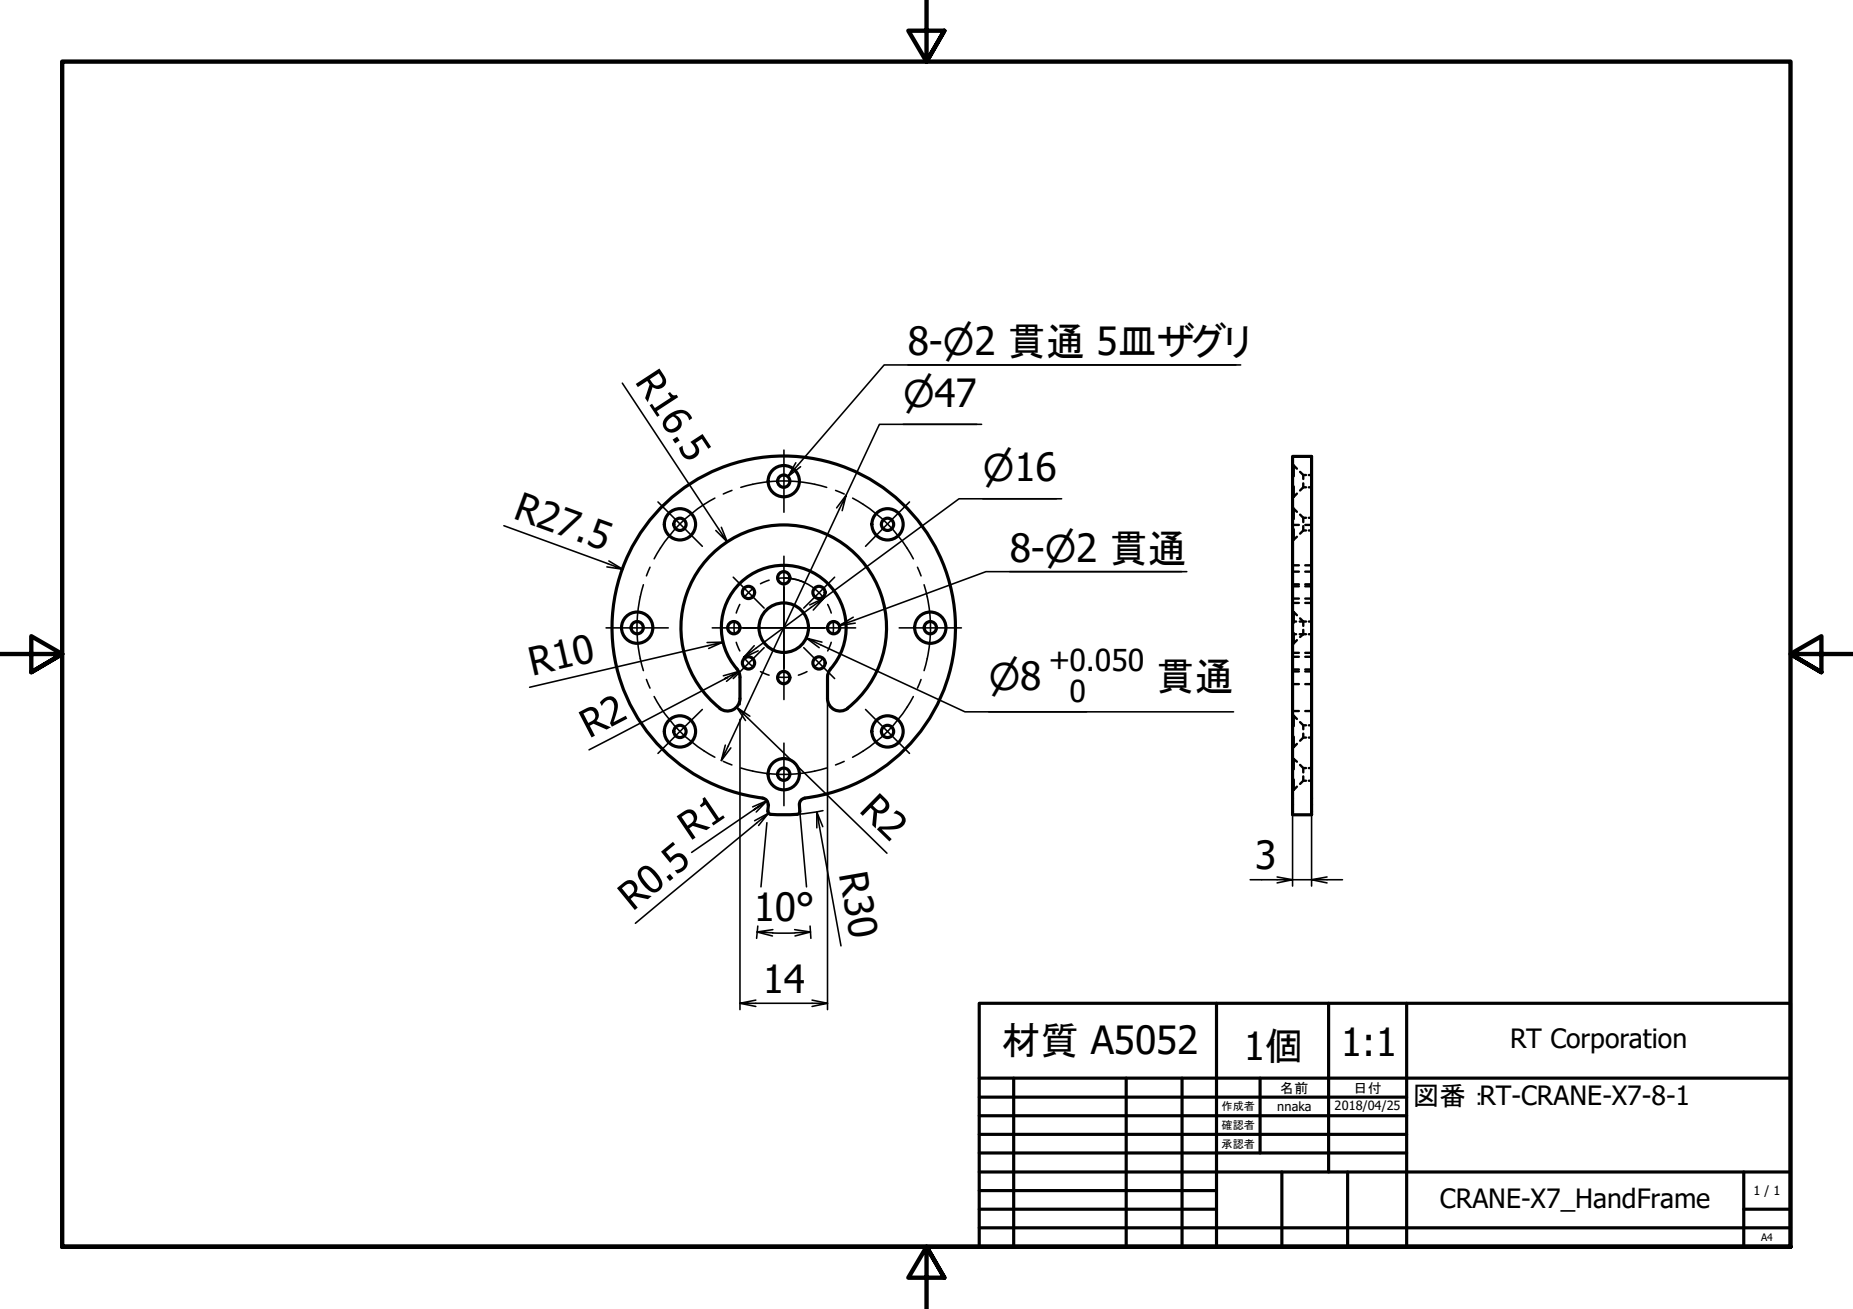
[picture p53: page 1]
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
