rt-net/sciurus17_Hardware/Drawing/アルミフレーム(6812ZZ+XM540).pdf

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

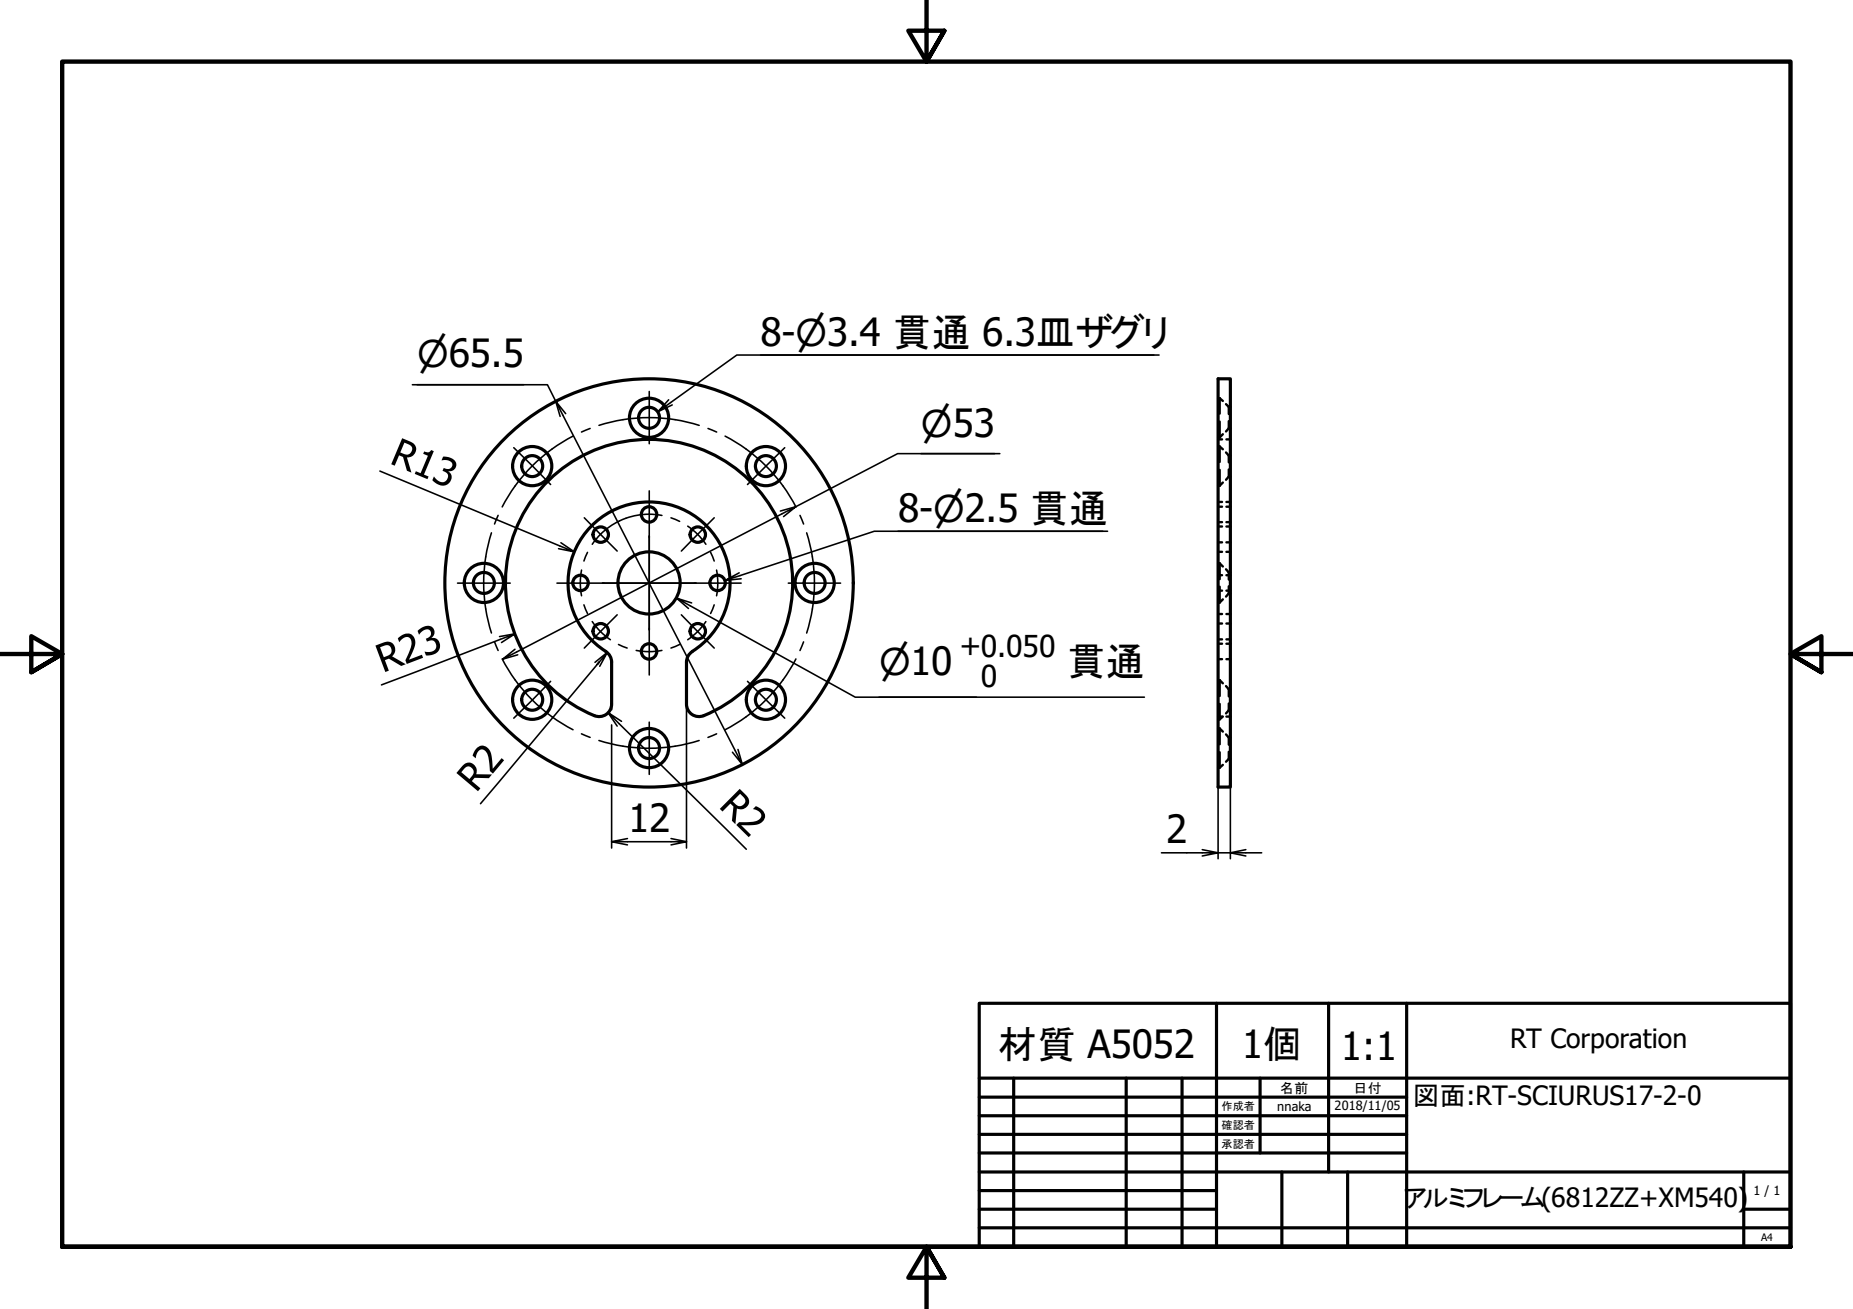
[picture p54: page 1]
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
