rt-net/sciurus17_Hardware/Drawing/アルミフレーム土台A.pdf

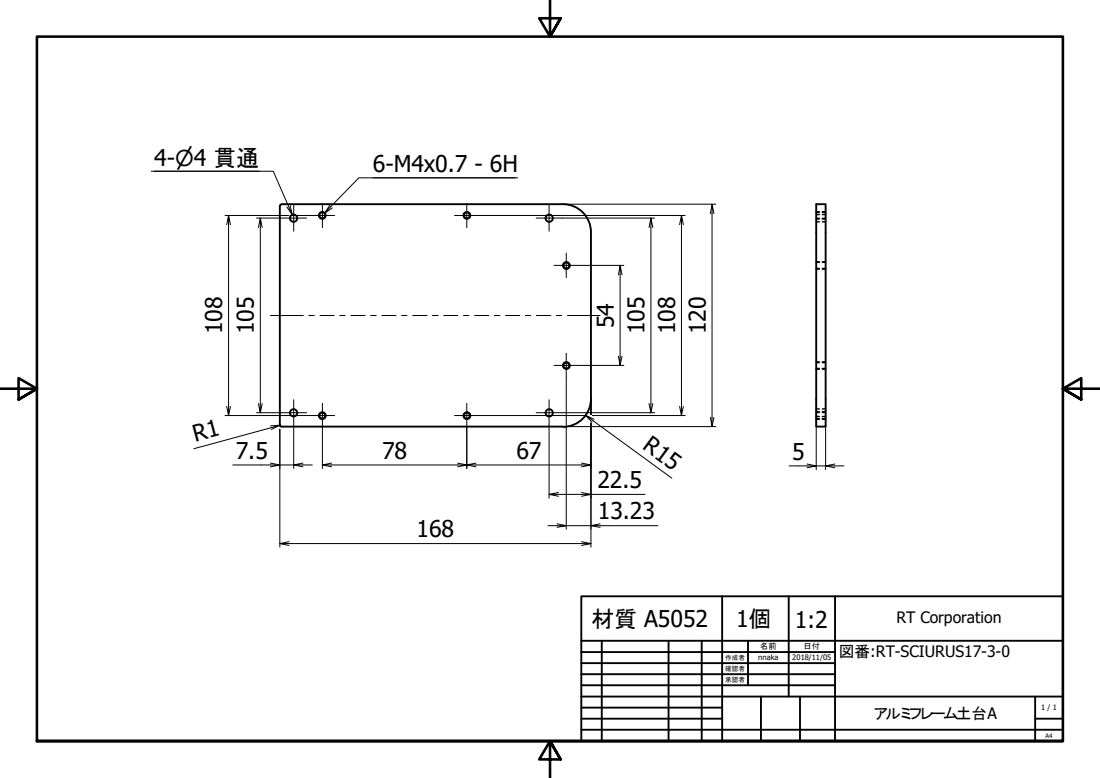
[picture p61: page 1]

A5052 | 1 | 1:2 | RT Corporation

 |  | :RT-SCIURUS17-3-0

 | nnaka | 2018/11/05
