rt-net/sciurus17_Hardware/(commit log)

2018-08-03 Update README.md
    readmeに記入
2018-10-31 3D printing data
2018-10-31 Head&Neck data upload
    [Sciurus17_HeadA1.stl, Sciurus17_HeadA2.stl, Sciurus17_HeadA3.stl, Sciurus17_NeckA.stl, Sciurus17_NeckB.stl]
2018-10-31 Body&Hip 3D printing data upload
    [Sciurus17_BaseCover.stl, Sciurus17_BodyA1.stl, Sciurus17_BodyA2.stl, Sciurus17_BodyC.stl, Sciurus17_CameraBustMountA.stl, Sciurus17_CameraBustMountB.stl, Sciurus17_HipA.stl, Sciurus17_HipB1.stl]
2018-10-31 Right&Left Arm 3D printing data upload
    [Sciurus17_Left_BaseA.stl, Sciurus17_Left_BaseB.stl, Sciurus17_Left_Link1A.stl, Sciurus17_Left_Link1B.stl, Sciurus17_Left_Link2A.stl, Sciurus17_Left_Link2B.stl, Sciurus17_Left_Link2C.stl, Sciurus17_Left_Link2D.stl]
2018-10-31 CAD step data upload
2019-03-13 Update assembly manual
2020-09-11 Add hand STL files. Update the directory layout (#1)
    * update README
    * Rename directories
    * update README
    * Add hand stl files.
    [Sciurus17_BaseCover.stl, Sciurus17_BodyA1.stl, Sciurus17_BodyA2.stl, Sciurus17_BodyC.stl, Sciurus17_CameraBustMountA.stl, Sciurus17_CameraBustMountB.stl, Sciurus17_HeadA1.stl, Sciurus17_HeadA2.stl]
